karthikeya-ms/SAE-Aerodesign-Challenge-2020/SAE Aerodesign/final draft ppt.pptx

## SAEISS Aero Design Challenge 2020, Regular Class SASTRA Deemed To Be University, Thanjavur Technical Presentation

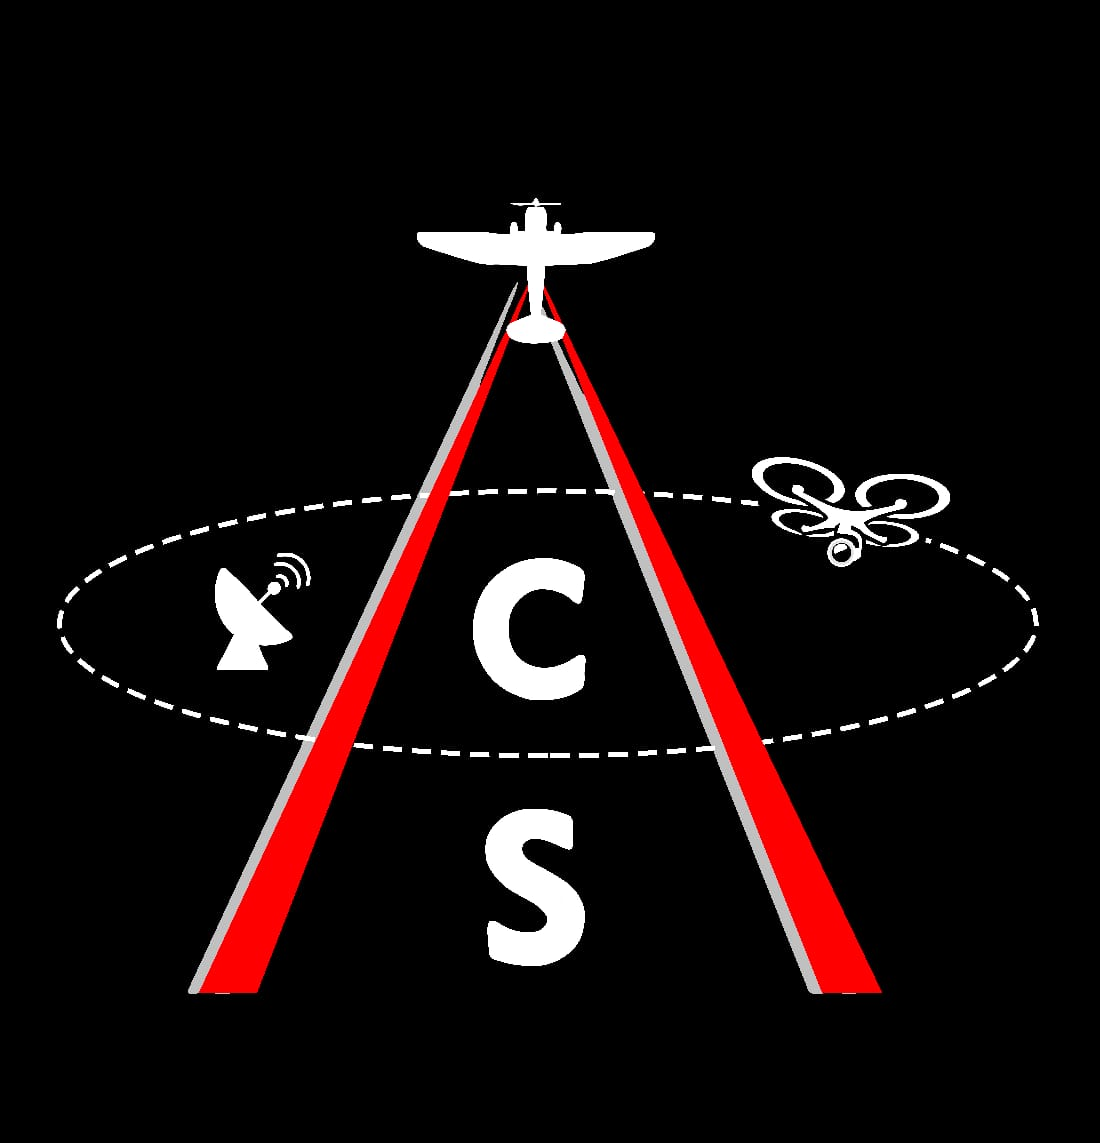
[picture p1: figure]

By
Team Udyat ADC2020114

## Project Planning

- Project approach
To practically apply our Theoretical Knowledge combined with our thought processes. Mimicking a fully functional aerospace engineering firm.
- Project Timeline

Team Registration and Memberships
Initial Discussions
Literature and Design Report Study
Sub-System Allocations and Working
Design Report completion and Submission
Fabrication /Technical Preparation
Test Flight and changes
Order of Components and Materials

Design Approach
- Conceptual Design
Detailed Design

## SAE AERO-DESIGN COMPETITION ROADMAP

- 2019

- 2020

- August

- Understanding problem-statement

- Team meetings
- Weight estimation

- September

- Modelling
- Design report

- December

- Semester exams
- Material selection
- Dealers contact

October

- Attending workshop
- Basic calculations

- November

- 2019-2020

- Final design report
- Scale down model

- Fabrication
- Technical presentation

TEAM UDYAT

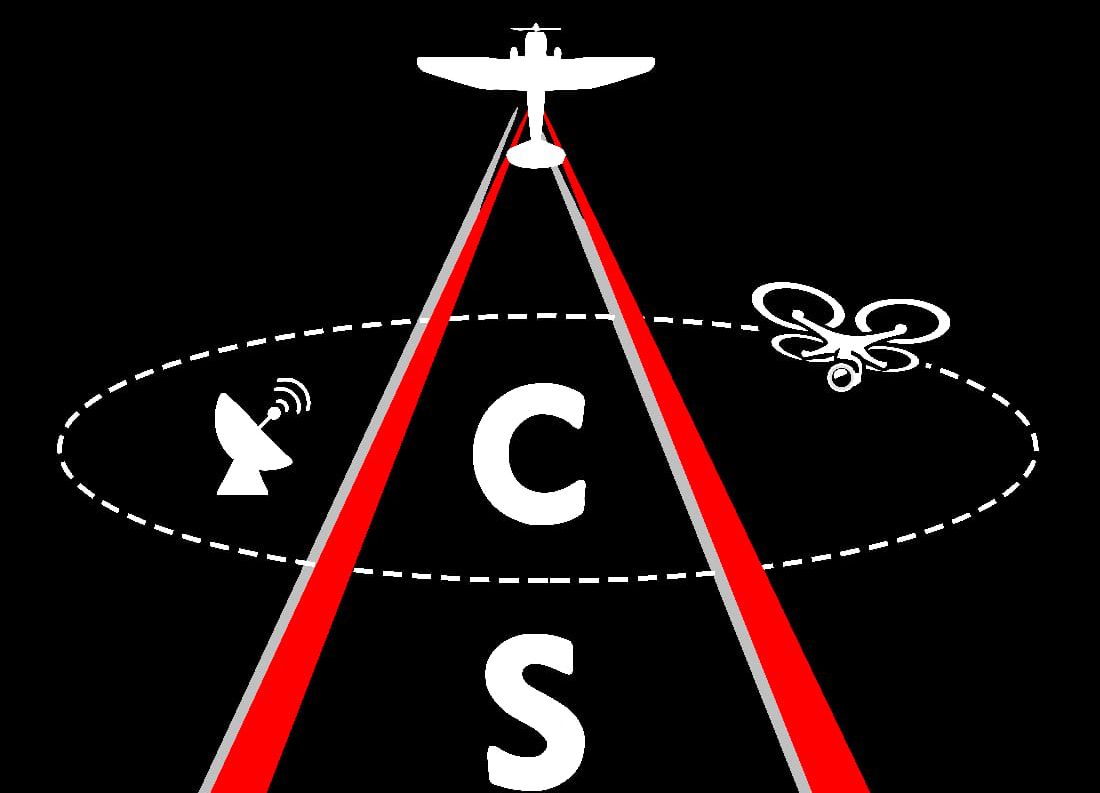
[picture p2: figure]

- January

- February

* Literature study is a part of all months

## Design Approach

Conceptual Design

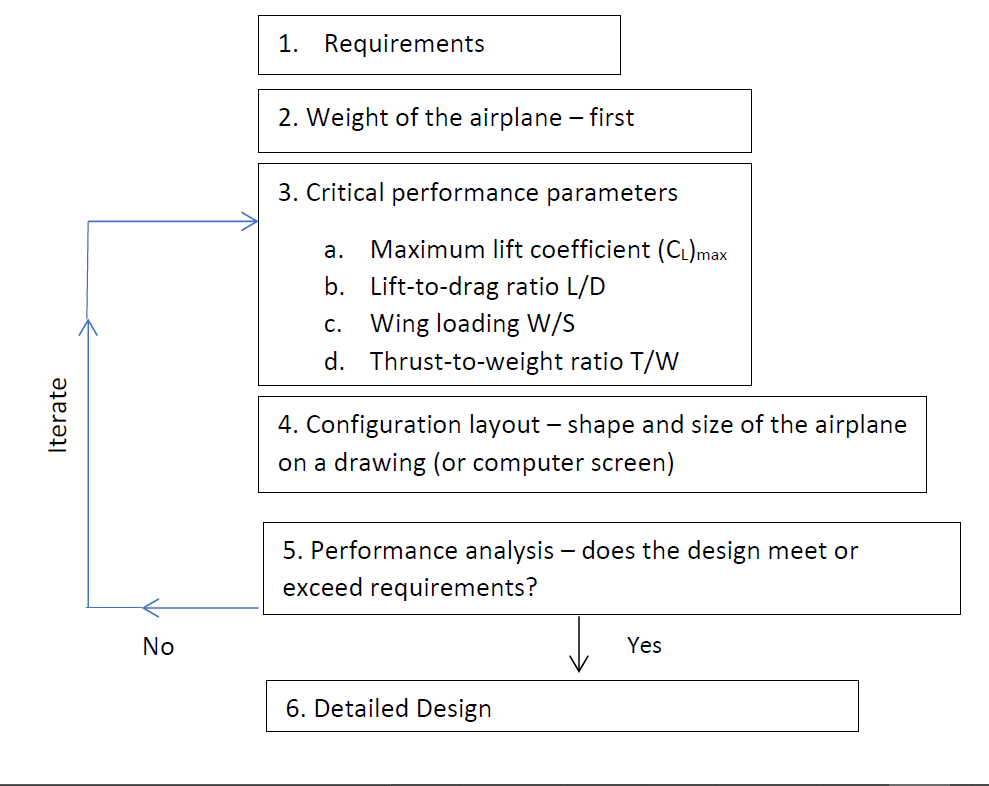
[picture p3: figure]

Detailed Design

1. 3-D drag analysis
2. Structural Analysis.
3. Power Plant.
4. Material Selection.
5. Fabrication Feasibility.

## Procedure

UDYAT plane
Weight estimation
Wing design
Empenage
Fuselage
C.G location
Landing gear

## Requirements and Constraints ( Include Sae plane)

Propulsion System

FRP and Lead Prohibited

Problem statement

Ss

SAE
Requirements and Constraints

Additional Constraints

Total Take off distance 200ft.
Total Landing distance 400ft.

Total Length <170 inches .
2kg <Weight<5kg

Time

Fabrication Feasibility

Cost

## Slide 7

FRP and Lead Prohibited

Propulsion System

Problem statement

SAE
Requirements and Constraints

Additional Constraints

Total Take off distance 200ft.
Total Landing distance 400ft.

Total Length <170 inches .
2kg <Weight<5kg

Time

Fabrication Feasibility

Cost

## Configuration Selection and Trade Studies

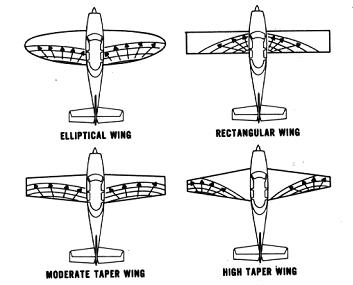
[picture p4: figure]
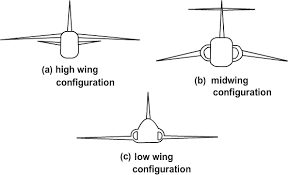
[picture p5: figure]

Evaluation Criteria:
- Less impact during landing
- Laterally stable
- Smooth finish of Fuselage
- Ease of Wing-Fuselage Assembly.

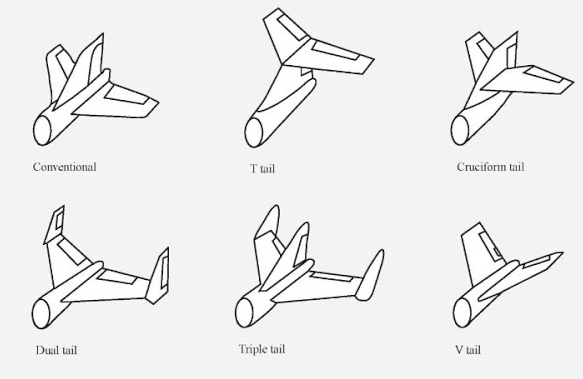
[picture p6: figure]
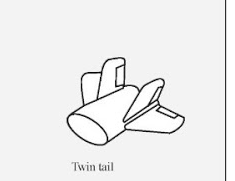
[picture p7: figure]

Evaluation Criteria:
- Induced drag
- Weight Reduction
- Near Elliptical Distribution
- Manufacturability

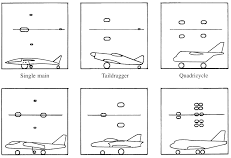
[picture p8: figure]

Evaluation Criteria:
- Reduced Parasite drag
- Reduced rudder-induced roll
- Free of fuselage wake
- Reduced Cantilever stress

Evaluation Criteria:
- Prevents Ground looping
- A
- Ad

Fuselage Evaluation Criteria:
- Innovation
- Reduced Influence of Wing wake on Tail
- Ease of manufacturing

## Vehicle Sizing

- Vehicle was sized based on competition requirements, meanwhile considering the aerodynamic characteristics and structural integrity.
- Aerodynamic parameters and Fabrication feasibility were considered, iterated and necessary design changes were made.

Airfoil Selection

Volume Coefficients

Horizontal Stabilizer Dimensions

Lift Requirement

Payload Requirement

Wing Dimensions

Avionics Requirement

Fuselage Dimensions

Vertical Stabilizer Dimension

## Slide 10

Wing

Wing configuration

Wing planforms

Airfoils

- Wortman fx-63-137
- E-423
- S1210
- S1223

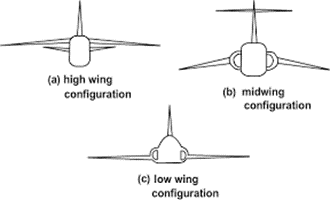
[picture p9: figure]
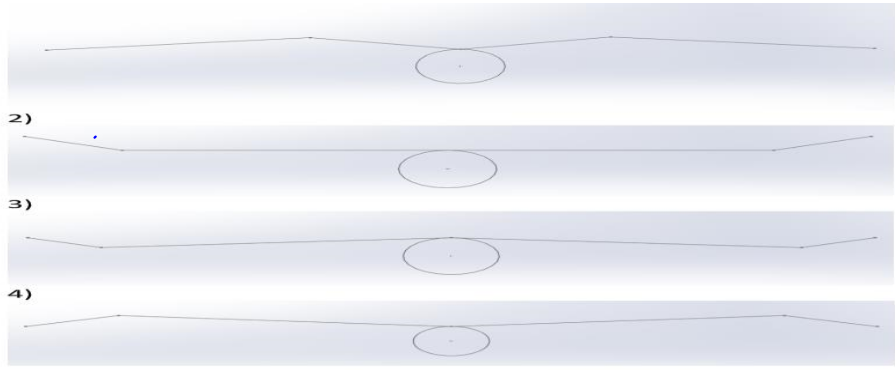
[picture p10: figure]

Wing specifications

## Slide 11

Fuselage

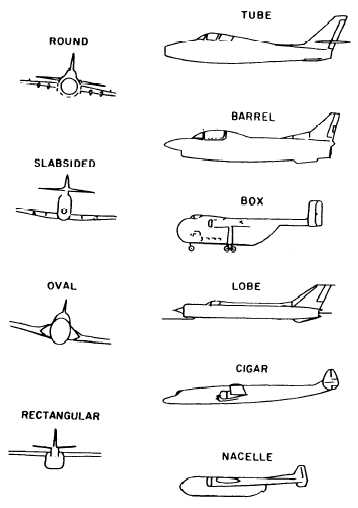
[picture p11: figure]

Fuselage front view

INNOVATION:
- The purpose of the step, it is claimed, is to allow some of the displaced air to fall into a pocket behind the step and become part of the airfoil shape as a trapped vortex. This purportedly prevents separation and maintains airflow over the surface of the airfoil. A similar step is made after the diverging part of fuselage to attach the flow and reduce the slope of decrease in lift.

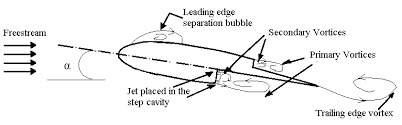
[picture p12: figure]
Image result for kline fogleman airfoil gif
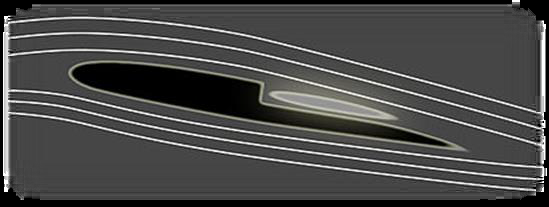
[picture p13: figure]
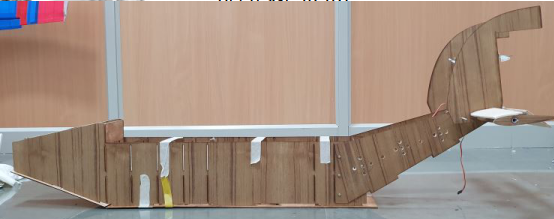
[picture p14: figure]

Fuselage side view

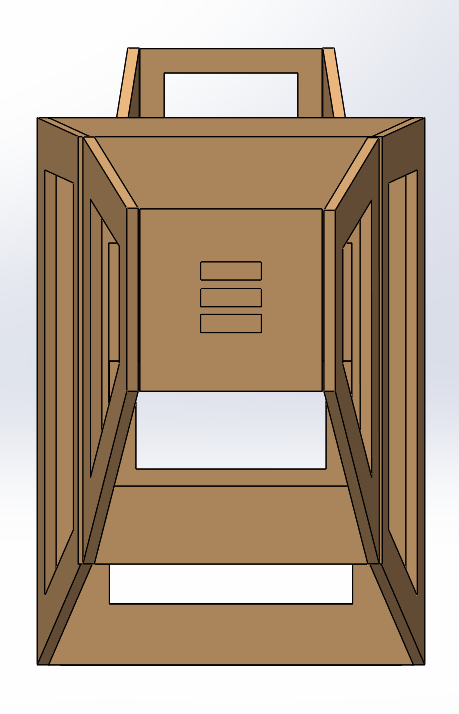
[picture p15: figure]
fuselage solidworks front view

## Innovation

- The purpose of the step, it is claimed, is to allow some of the displaced air to fall into a pocket behind the step and become part of the airfoil shape as a trapped vortex. This purportedly prevents separation and maintains airflow over the surface of the airfoil. A similar step is made after the diverging part of fuselage to attach the flow and reduce the slope of decrease in lift.

## Vehicle Sizing

Aerofoil Selection
(Wind-Turbine blades)

Performance Parameters

Maximum Lift Co-efficient

Maximum L/D Ratio

Wing-Loading

Informal Optimisation of Cruise-Velocity

Optimisation of Aspect Ratio

WING-DIMENSIONS

## Slide 14

- Vehicle was sized based on competition requirements, meanwhile considering the aerodynamic characteristics and structural integrity.
- Aerodynamic parameters and Fabrication feasibility were considered, iterated and necessary design changes were made.

Payload Requirements

Manufacturing Ease

Avionics Requirements

Fuselage Dimension

Volume Coefficients

Wing- Dimensions

Aerofoil

Vertical and Horizontal Stabiliser

## Slide 15

Vehicle Sizing

Performance parameters

Wing loading

Airfoil

Max L/D ratio

Aspect ratio

Max. lift coefficient

Wing Dimensions

Cruise velocity

Avionics requirement

Stabilisers

Volume coefficients

Payload requirements

Fuselage dimensions

Manufacturing Ease

## Slide 16

WING

Required Lift L=5.75Kg
Assumed Speed Vc=10m/s
Airfoil= S1223

Airfoiltools.com

For Wing: CLmaxw= Clmax * 0.95= 2.177
CL ideal = Cl ideal *0.95= 1.0973
For Aircraft: CLAmax = 2.177* 0.9=1.95
CLA ideal= 1.0973*0.9= 0.98

Lift = ½* ρ∗Vc2∗S∗CLmax.
56.4075= .5*1.225* 100* S* 1.95
Span area (S)= .4722 m2. = 732in2.

Landing Distance
Sg=1.21∗(W/S)/ (g∗ρ∗CLAmax∗T/w)

Span Length (b)= 71.58in
Mean Aerodynamic Chord MAC = 10.22in

Literature Study and Optimisation of Aspect Ratio.
A.R= 7

T/W= (1.21*20)/ (32.2*0.002377*1.95*200) = 0.81.

## Tail-Section

Horizontal Stabilizer
(PITCH STABILITY)
Literature Study NACA 0009, Volume Coefficient 0.6

Formal Optimisation of Span area
130 sq. in

- ARh=(2/3)ARw=4.66
- Span length=24.61 in
- chord=5.27 in
- Elevator chord=2 in
- Elevator length=24.61 in

Vertical Stabilizer
(DIRECTIONAL STABILITY)
Literature Study Volume Coefficient 0.05

Vv =. (Sv∗Lv)Sw∗b

Formal Optimisation of Span area
83 sq. in

- ARh=2.5
- Height=12 in

## Slide 18

Empennage

Horizontal & vertical Stabilizer

Tail cone side view

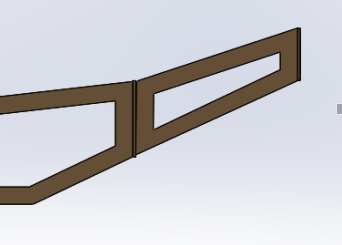
[picture p16: figure]
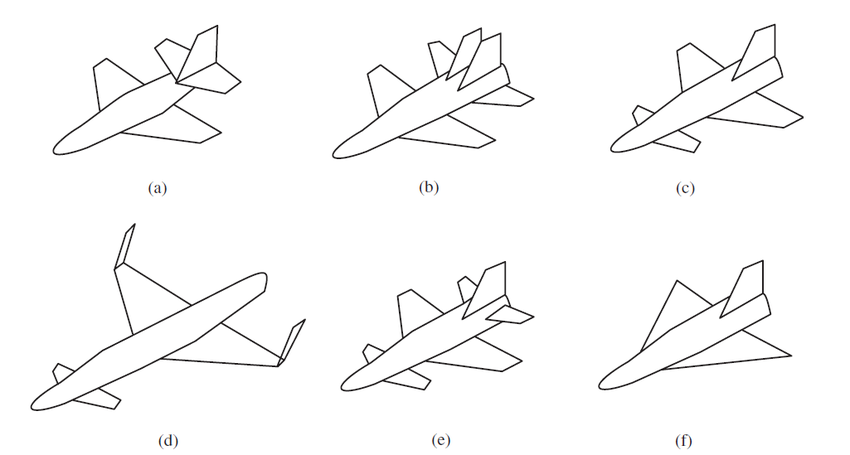
[picture p17: figure]
Image result for tail configuration

Airfoil-NACA0009

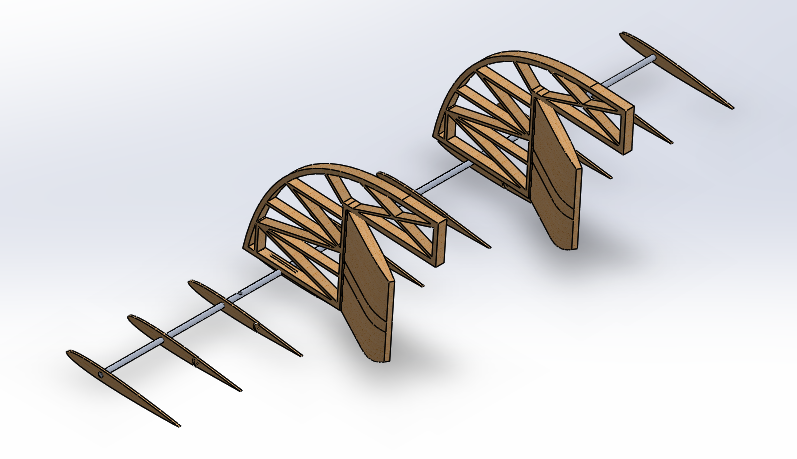
[picture p18: figure]
empennage isometric view solidworks

Tail isometric view

## Slide 19

Landing gear

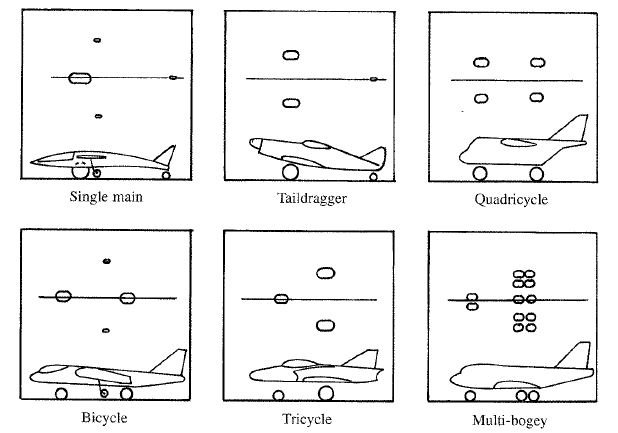
[picture p19: figure]

## Centre of Gravity and stability

Xflr
COG location using XFLR5: 1.997(from MAC of 10.1 in)

Analytical

Xnp = 3.027 inches (for 10.1 inches MAC).
We chose the mid value of Stability margin which is 0.10.
Xcg = 2.017 inches (from MAC of 10.1 inches).

## Stress analysis and Material Selection

Distance Between Ribs:

Cp=(Po−Pa)/ 5∗ρ∗Vc².

| Density, g/cc | Strength, MPa | Specific strength | Youngs Modulus, GPa | Flexural Modulus, GPa | Elongation, % | Fatigue Mpa
Balsa Wood | 1.63 | 30 | 18.40 | 3.71 | NA | NA
Depron | NA | NA | NA | NA | NA | NA
Corrugated plastic | NA | NA | NA | NA | NA | NA
Elasto foam | NA | NA | NA | NA | NA | NA
FRP | 1.5 | 85 | 56.67 | 3.4 | 3.6 | 5
PLA | 1.25 | 65 | 52.00 | 3.5 | 4.5 | 12
ABS | 1.08 | 55 | 50.93 | 3.1 | 2.5 | 20
Nylon 6 | 1.12 | 70 | 62.50 | 3.1 | 2.6 | 35
Nylon 66 | 1.14 | 90 | 78.95 | 2.9 | 2.4 | 45
PEEK | 1.3 | 95 | 73.08 | 4 | 3.8 | 45
Torlon | 1.42 | 170 | 119.72 | 4.9 | 5 | 15
Al 7075 T6 | 2.7 | 570 | | 71GPa | | 10 | 300

Material Selection Trade-Off

Po−Pa= 350 Pa

Iterative Process

## Empirical Results

## Lessons Learnt

- We have the aerodynamic knowledge, the structural materials, the powerplants, and the manufacturing capacities to perform any conceivable miracle in aviation. But miracles must be planned, nurtured, and executed with intelligence and hard work”.
- Glenn L. Martin, aviation pioneer and manufacturer, 1954.
- Checking the availability of necessary components before coming to design conclusions.
- Fabrication and Manufacturing required a yet another different set of skill.
- Time Management
- Finance management

## Queries?
