karthikeya-ms/SAE-Aerodesign-Challenge-2020/SAE Aerodesign/SAE_Aerodesign 2020 Final report.pdf

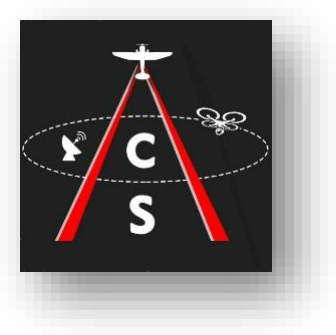
[picture p20: figure]

Society of Automotive Engineers

Aero Design Challenge 2020

(SAEISS-ADC 2020)

## Design Report of an Electric Motor-Powered Radio Controlled Heavier-

than-air Regular class Aircraft.

Submitted by

Team Udyat (ADC2020114)

SASTRA Deemed to be University, Thanjavur

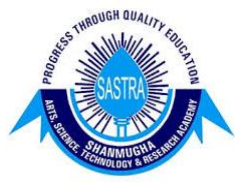
[picture p21: figure]

M Siva Karthikeya | B Harshin Balaji
Pothabathula Hema Prathyusha | S N Vijay
Prateek Boga | Amal Xavier Christo.C

### M S Hari Krishna (Team Captain)

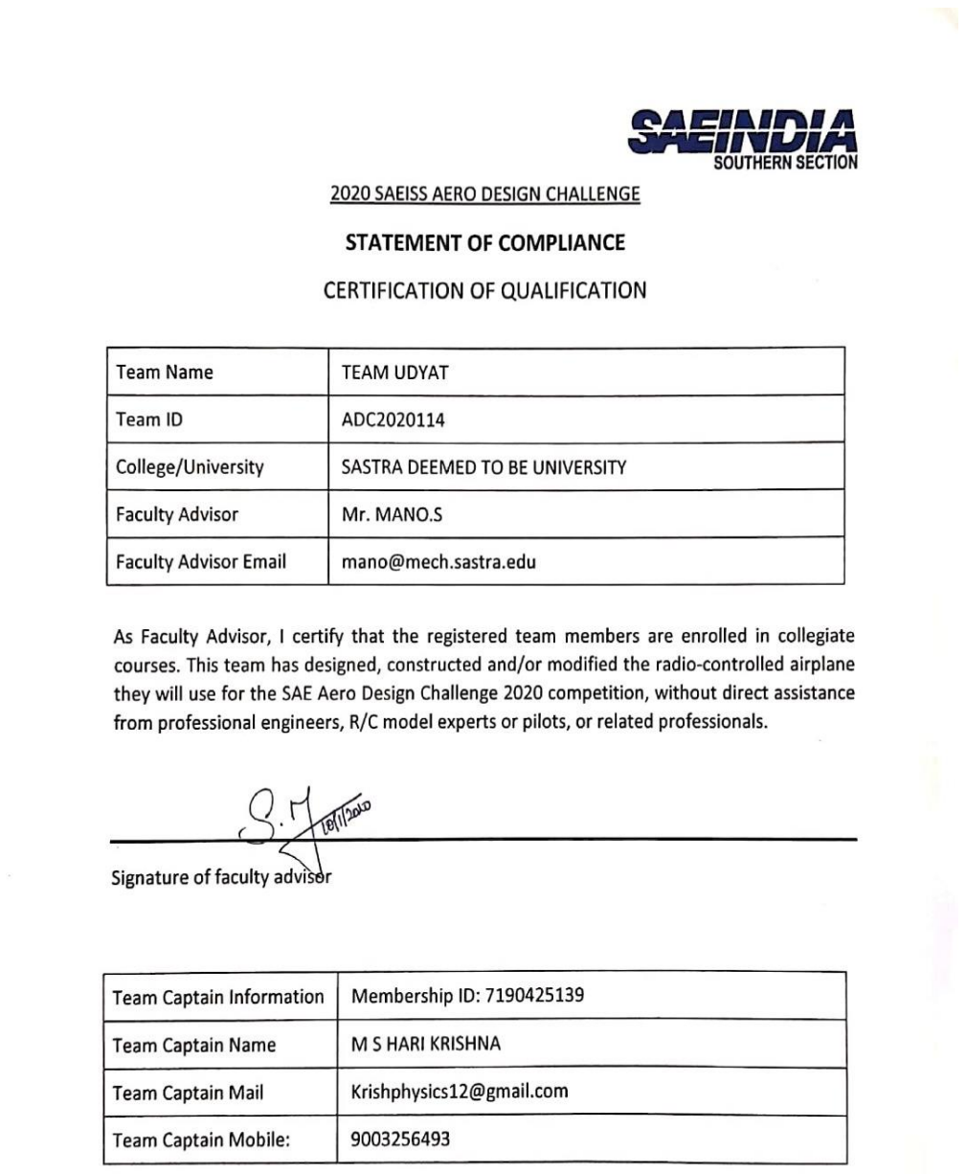
[picture p22: page 2]

TABLE OF CONTENTS:

3.1.4.4 Fuselage construction

8. 2D diagram and References | 30, 31

### 1. Acknowledgement

‘No man is an island’ said John Donne. Team Udyat is lucky to be connected to many others who keep

us from being ‘rifted’. For creativity has no greater sustenance than the love and support of others, we

would like to spare this page to acknowledge some of them.

We thank our parents and family members, without whom finishing this report successfully on time

would have been strenuous.

Dr. P. Bala Srinivasan- Associate Dean (Research), School of Mechanical Engineering, SASTRA

University. He has been our teacher, mentor, well-wisher and has constantly encouraged us in all our

challenging situations. We thank him for his guidance in ‘Material selection’.

Dr. Hariharan Sankara Subramanian, SAP, SASTRA University, for guiding us through all SAE-

related procedures.

Mr. Mano. S, Faculty advisor of Team Udyat, for his guidance and support since the beginning of this

project.

Our Seniors: M. Narasimha Vardhan (IIT-M), Lakshmi Das and S. Shyam, for sharing their

experiences and knowledge in aeromodelling. Their suggestions and pointers have been of immense

help in executing this project. We are extremely grateful for their support.

Our friends: S. Nithish Kumar for being a part in all our discussions and correcting us whenever

required; A. Ithikhash for giving us the ‘feel’ of materials and in finding dealers; Shreya

Venkataraman for patiently editing this document.

We finally thank almighty for his blessings!

### 1. Introduction:

Engineering: “The application of scientific principles to practical ends”- American Heritage Dictionary

This was the motto behind the formation of Team Udyat, a team of seven engineering students from

Aerospace and Mechanical Department of the Aeromodelling club at SASTRA(ACS). We decided to

utilise the golden opportunity of taking part in the annual Aero Design Challenge 2020 organised by the

Society of Automotive Engineers (SAEISS), which we consider as a great platform to practically apply

our theoretical knowledge combined with our thought processes.

There are two classes- Regular and Micro. Following an intense discussion and thorough understanding

of the rules, Team Udyat decided to take part in the Regular class. As we had experience only in making

micro class vehicles, the main objective behind choosing the Regular class was to challenge our fear of

making a huge aircraft with good flight performance that adhere to the rule book prescribed by SAEISS.

Here, I would like to proudly add that our college seniors, Team BALLISTIC took part in SAEISS ADC

2017 and won overall 2nd. Their guidance and moral support gave us immense confidence to initiate this

project.

Project Planning:

“We have the aerodynamic knowledge, the structural materials, the powerplants, and the manufacturing

capacities to perform any conceivable miracle in aviation. But miracles must be planned, nurtured, and

executed with intelligence and hard work”.

- Glenn L. Martin, aviation pioneer and manufacturer, 1954.

Our initial team meetings mainly consisted of discussions on how to approach this project, as SAEISS

not only looks for an airplane design that is certified best for flying, but also assesses the student’s team

dynamics, discipline in approaching a problem, and various other skill sets.

### 2. Design approach:

We decided to split our process of fabricating this aircraft into two phases, namely, Conceptual Design,

and Detailed Design. These two covers the web of details that surrounds and interconnects all other

parameters that is required for designing an efficient airplane.

2.1Conceptual Design

We covered 5 pivot parameters under this heading, which is given below as a flow chart.

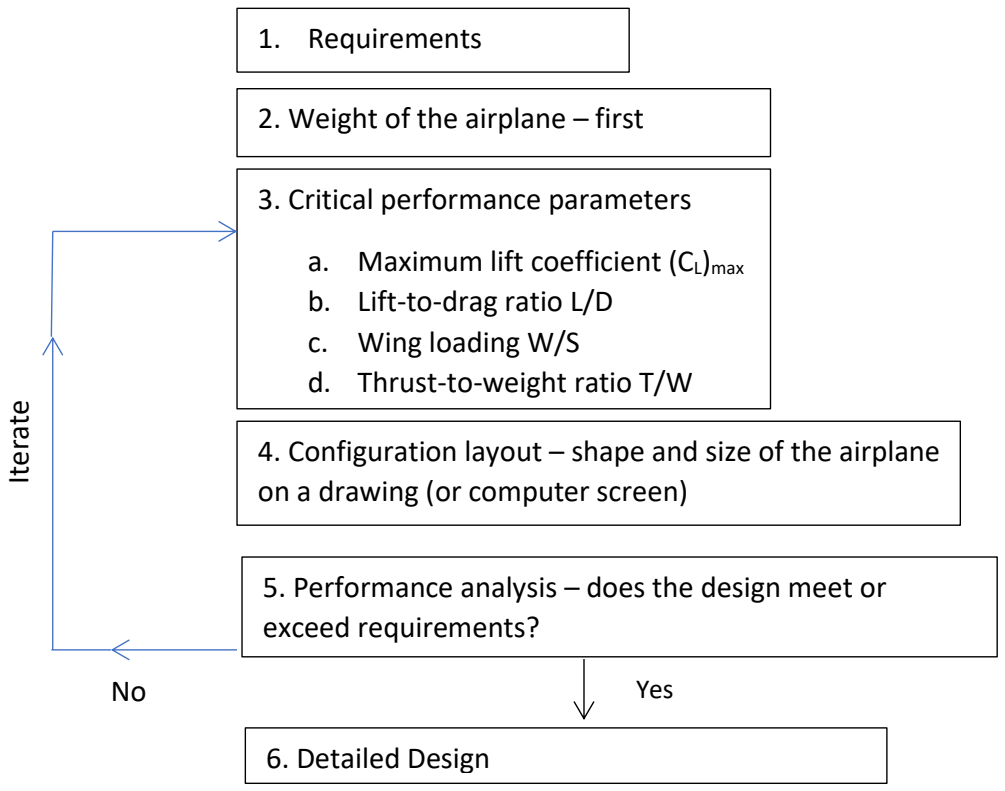
[picture p23: figure]
exceed requirements?; 6. Detailed Design; 1. Requirements; 2. Weight of the airplane – first; 3. Critical performance parameters; a. Maximum lift coefficient (CL)max b. Lift-to-drag ratio L/D c. Wing loading W/S d. Thrust-to-weight ratio T/W; on a drawing (or computer screen); Iterate; Yes

### 3.1.1. Requirements and constraints:

- To design an aircraft that can lift as much as weight as possible while observing the available

power and aircraft dimensional requirements. Accurately predicting the lifting capacity of the

aircraft is an important part of the exercise as prediction bonus points often determine the

difference in placement between competing teams.

5. Performance analysis – does the design meet or
4. Configuration layout – shape and size of the airplane

- Total dimensions of airplane not more than 170 inches.
- Total weight of empty aircraft not less than 2 Kgf and not more than 5 Kgf.
- Use of FRP is prohibited.
- LiPo battery 4 cell – 6 cells.
- Total Take-off distance- 200ft
- Total Landing distance- 400ft.

### 3.1.2. Weight of the Airplane - First Estimate & Material Selection:

No airplane can get off the ground unless it can produce a lift greater than its weight. Hence, it was

important to consider and approximately calculate the gross weight of the aircraft as all the other

aerodynamic parameters such as lift, thrust required, span length of the wing, etc. depended on it.

We classified the gross weight in to two - Weight of the payload (Wp) and empty weight of the aircraft

(including electric components, We).

The primary purpose of this aircraft is to have a stable flight and lift as much payload as possible, for

which having a higher payload fraction is essential. Payload fraction is defined as the ‘ratio of weight of

the payload to the take-off weight of aircraft’. This can be achieved by decreasing the empty weight of

the aircraft. Since the minimum weight of the aircraft should be 2Kgf, we considered building an aircraft

weighing 2.3Kgf, leaving a clearance of 300g. We were very particular with this consideration as there

were high chances of increase in weight upon building. We made sure that the weight didn’t exceed

5Kgf. This was also a deciding factor in the selection of material (density). The empty weight of the

aircraft depends on the materials used and the electrical components. Intense study and research were

done for the selection of material. This was done to quench our thirst in discovering several non-

conventional, sustainable materials that can be used to build RC planes. After analysing the pros and

cons, cost, availability, ease of manufacturing and the other material parameters mentioned, we decided to go with Aluminium and various grades of Balsa wood. Although these are conventional materials,

this activity helped us explore a variety of materials, their manufacturing processes, cost and

availability. After going through literatures, we contemplated our payload fraction to be 0.6, which

yielded a result that our aircraft can lift a payload of 3.45Kgf.

Conclusion: The gross weight of the aircraft (We + Wp) = 2.3Kgf + 3.45Kgf = 5.75Kgf = 12.676lb.

### 3.1.3. Performance parameters:

An estimation of critical performance parameters like CL max, L/D, T/W, W/S was made as they form

the ultimate deciding criteria for calculation of span length, chord, aspect ratio, thrust required, etc.

Maximum Lift Coefficient: This is the stage where we made an initial choice of the airfoil. The aircraft

should be able to perform a stable 360⁰ turn. Hence, high speed and manoeuvrability can be neglected.

From historical data, Reynolds number for an RC aircraft ranges from 1,50,000 to 2,50,000, and upon

choosing an average value of 2,00,000, the average Cruise velocity obtained (Vc) is 9-10m/s (Ref.

airfoiltools.com).

Take off speed (VTO)= Cruise speed/1.2 = 7.8m/s. Stall Velocity = VTO /1.2 = 5-6m/s.

Now, the problem statement is to produce high lift at a relatively low Reynolds number, i.e. 2,00,000.

This is when wind turbines drew our attention, whose blade profile is capable enough to produce high-

lift in a velocity range of 9-10m/s. Research work made us shortlist the below mentioned airfoils:

- Wortman fx-63-137
- E-423
- S1210
- S1223

Design Objective | Weightage | Wortman | E-423 | S-1210 | S-1223
Cdmin | 25% | 5 | 3 | 5 | 4
Cmo | 15% | 2 | 3 | 3 | 4
Clmax | 15% | 3 | 4 | 4 | 5
αo | 10% | 3 | 3 | 4 | 4
(Cl/Cd) max | 10% | 5 | 2 | 4 | 3
Clα | 5% | 2 | 3 | 3 | 4
Stall Quality | 20% | 2 | 2 | 3 | 5
Summation | 100% | 3.30 | 2.85 | 3.85 | 4.25
Table.1

Comparatively, the overall performance of S-1223 proved to be better. This was a validation to our gut-

feeling that S-1223 would inherently perform well since it is widely used for RC plane (Historical data).

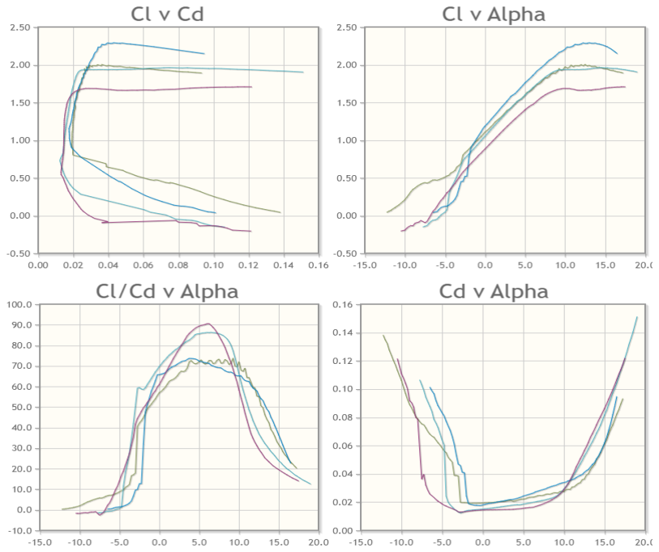
[picture p24: figure]

Colour code:

Pale blue: S1210

Blue: S1223

Green: E423

Violet: fx-63-137

Specifications of S-1223:

Clmax @ A.O.A=16⁰ | 2.2919
Cl @ A.O.A= -7.5⁰ | 0
(Cl/Cd) max @ A.O.A =3.75⁰ | 73.64
Cl ideal (Cl ideal is when the corresponding Cd is minimum) | 1.1554
Cd min | 0.01758
Cl @ A.O.A=0⁰ | 0.01758
(Thickness/chord) max = 12.1/19.8 | 0.611
Parasite Drag Co-efficient (Cd0) | 0.01758
dCl/dα | 5.698
Table.2 | source:www.airfoiltools.com

Note: The aircraft has to fly at ideal lift co-efficient of 0.98 for it to experience minimum drag.

The gross weight of the aircraft is 5.75 Kgf. At cruise condition, Lift = Weight. Hence, the aircraft

should produce a Lift of 5.75*9.81= 56.4075N.

Lift = ½* ρ ∗ Vc²
∗ S ∗ CLmax.

56.4075= .5*1.225* 100* S* 1.95

Span area (S)= .4722 m². = 732 in².

Wing Loading (W/S): Wing loading is defined as the ratio of gross weight of the aircraft to the span area.

The faster an aircraft flies, more is the lift produced at each unit area of wing, since free stream velocity

is directly proportional to lift. Hence, even with a small span area, more weight can be lifted just by

increasing thrust and thus velocity.

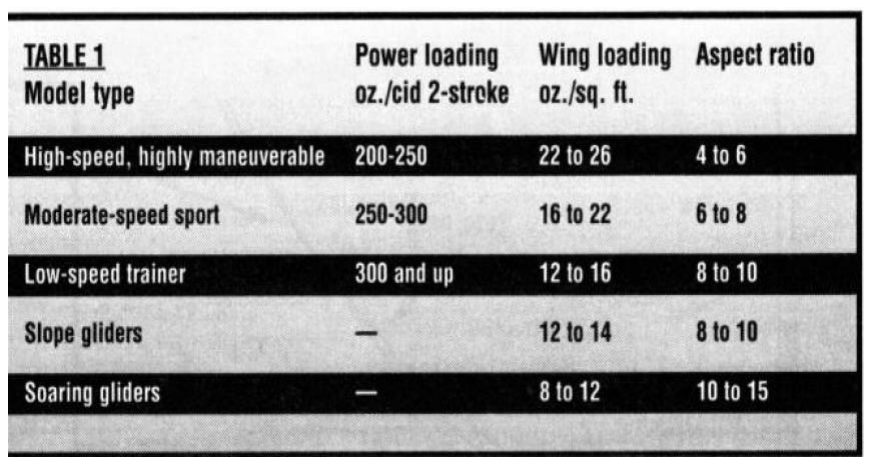
[picture p25: figure]

From the table, wing loading range of 16-22

oz/ft² is chosen. We arrived at this conclusion

because the requirements of a regular class

aircraft given by SAE restricts battery usage from

4-cell to 6-cell, which when powers a BLDC

For Wing: CLmaxw= Clmax * 0.95= 2.177

CL ideal = Cl ideal *0.95= 1.0973

For Aircraft: CLAmax = 2.177* 0.9=1.95

CLA ideal= 1.0973*0.9= 0.98 motor, generates speed that falls under moderate speed sport category. The corresponding Aspect ratio is

6-8, an average value of 7 is chosen. Aspect ratio = Span length (b) / Span area (S).

Thus, Span Length (b)= sqrt (732*7) = 71.58 in.

Mean Aerodynamic Chord (MAC)= Span (b) /Aspect ratio= 10.22 in.

Lift to Drag Ratio (L/D):

From Fig, the Cl/Cd max ratio for S-1223 is found to

be 73.64 at an angle of attack of 3.75. The

corresponding Cl and Cd is found to be 1.6172 and

0.02196 respectively. This is only for the airfoil, the

L/Dmax for the entire aircraft is calculated in 3-D drag

analysis section using drag polar equation.

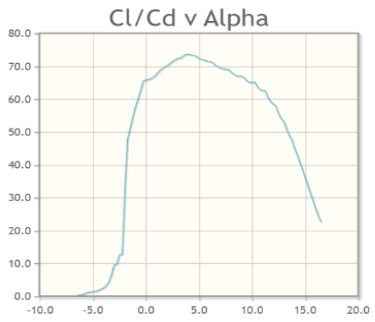
[picture p26: figure]

Thrust to Weight Ratio (T/W):

The value of T/W determines in part the take-off distance, rate of climb, and maximum velocity. Take-

off distance constraint is examined in here.

Sg = 1.21 ∗ (

W
S

)/ (g ∗ ρ ∗ CLmax ∗

T
w

)

Where, Sg is ground roll distance = 200ft.

W/S is wing- loading, taken as 20oz/ft² from wing-loading table given above.

g= acceleration due to gravity= 32.2 ft/s².

CLmax = 1.95

ρ= Density at sea-level= 0.002377 lb/ft

3

T/W= (1.21*20)/ (32.2*0.002377*1.95*200) = 0.81.

### 3.1.4. Configuration Layout:

Based on the information that has been calculated so far, the picture of aircraft with dimensions is

drawn. This section of intellectual process of airplane design is where intuition, experience and the art

of airplane design most strongly come in to play. We began with wing design (primary lift producer).

Number of wings-

(a) Monoplane | (b)Biplane
(c) Tri-Wing

Monoplane was chosen due to the below-mentioned advantages over any other number of wings.

1) Less weight, Ease of manufacturing and assembly operation.
2) Highest efficiency and lowest drag when compared to other configurations.

Wing vertical location- Feasibility analysis was performed to decide upon the vertical location of the

wing. Design objectives were narrowed down and each of it was given a specific weightage and then

rated accordingly for every vertical location. High wing has got the highest rating out of all due to many

reasons such as-

1) Facilitates the loading and unloading of payload into and out of the aircraft.
2) During landing, load on the landing gear will be transferred to the fuselage and very less to the wing

thus protecting the wing from harsh landings.

3) It increases the dihedral effect and makes the aircraft laterally more stable.
4) Aerodynamic shape of the fuselage lower section can me made smoother.

3.1.4.1 Wing design- From the primary dimensions of the wing obtained in the previous section such

as the chord length,

span length and span

area, the team had

intense brainstorming

sessions to decide on

the | wing

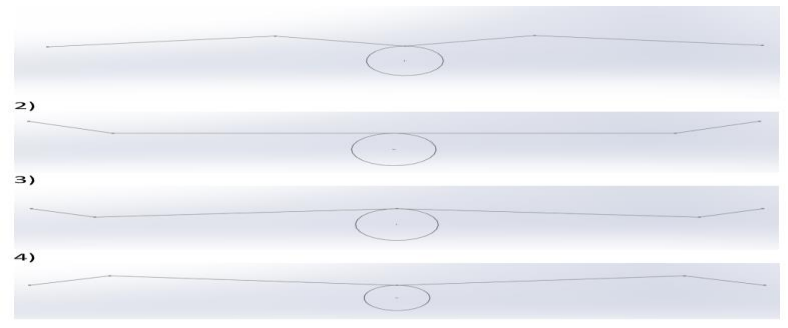
[picture p27: figure]

configuration. We came up with 4 different wing designs drawing inspiration from nature which are

shown above.

During the decision-making process 8 important parameters had to be considered before arriving at a

particular wing configuration. They are:

1) Aspect ratio-

It's the ratio of a wing's length to its chord. Both low aspect ratio and high aspect ratio wing have both

advantages and disadvantages so a middle value was taken. The aspect ratio was chosen as 7.

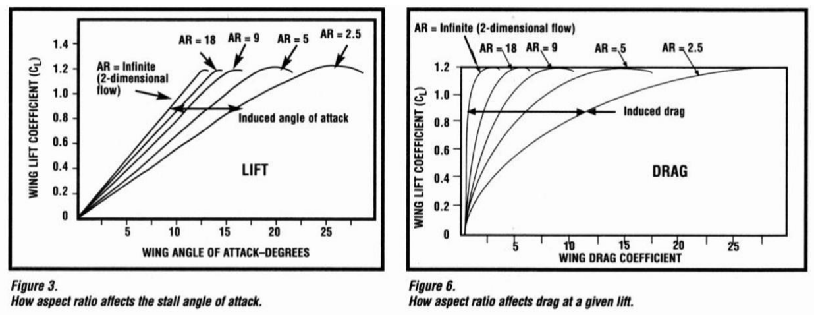
[picture p28: figure]

2) Taper ratio-

The prime purpose of tapering our airplane wing is to attain elliptical lift distribution which has the

highest efficiency when compared to any other distribution. One way to attain this is by making the

wing planform elliptical which is done by varying the chord length gradually across the span length.

This type of wing though aerodynamically has the best characteristics, is rated the least when the

manufacturing aspect is considered.

When the team was doing

literature study to find other ways

of | attaining | elliptical | lift

distribution, we came across the

concept | of | taper. | The | lift

distribution of a tapered wing is

very close to elliptical and the

factor that tells us about this

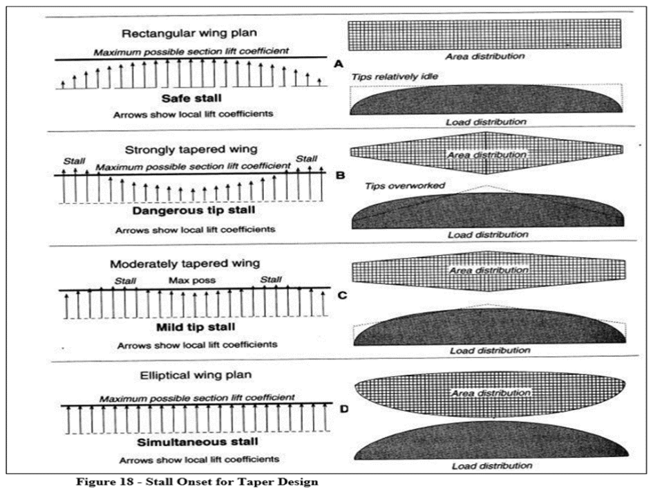
[picture p29: figure]

closeness is the Oswald span efficiency factor (e). For a tapered wing, this factor lies in the range of 0.90

to 0.98. Also, another factor to consider after deciding to taper the wing is the taper ratio which is

defined as the ratio of tip chord to root chord. Taper ratio= Ct / Cr

Optimum range of taper ratio for an RC plane is 0.2 to 0.6. Beyond 0.6 or below 0.2 the wing

experiences a phenomenon known as tip stall which is considered extremely dangerous for a plane

during flight. We decided the Taper ratio of our plane to be 0.58.

3) Sweep angle- Since Sweep angle is used in aircraft which fly in supersonic and high-speed subsonic

regions and our plane is designed to fly in low subsonic region, the sweep angle is neglected.

4) Tip chord and Root chord- After deciding the span area and the aspect ratio for a moderate category

aircraft, wing’s mean aerodynamic chord can be decided using the below mentioned formulas.

b

2 / S = AR | b / c = AR

The MAC obtained by the team was 10.1 inches. Root chord and tip chord can be calculated using the

below mentioned equation

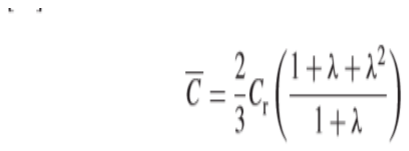
[picture p30: figure]

Root chord- 12 inches, Tip chord- 7 inches, MAC- 10.1 inches

5) Dihedral angle-

It is the upward angle from the horizontal of the wings. The purpose of dihedral angle is to provide

lateral stability. Dihedral angle 5 degrees was chosen (historical data).

6) Aerodynamic and Mechanical twist- Aerodynamic

twist: If the tip airfoil and the root airfoil are not the

same, the twist is referred to as aerodynamic twist.

Geometric twist: When the tip incidence angle and the

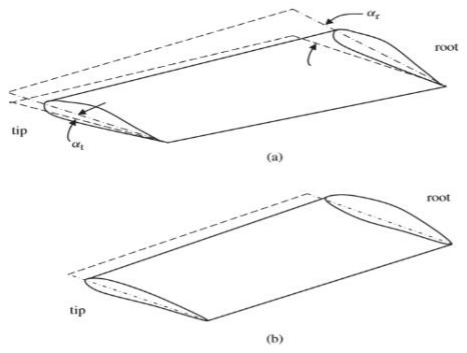
[picture p31: figure]

root incidence angle are not same, the twist is referred to as geometric twist.

Two major goals for employing a twist (aerodynamic or mechanical) in a wing are-

1) To avoid tip stall
2) To modify the lift distribution into an elliptical one

Even though providing twist can drastically vary the properties of a wing favourable to us, it brings

immense difficulties from a manufacturing point of view. Since ease of manufacturing was top priority

among all other aspects, we decided not to include a twist in our wing.

7) High lift devices – High Lift Device is a component that increases the amount of lift produced by the

wing. The device may be a fixed component, or a movable mechanism which is deployed when

required. We have gone with flaps which is the most commonly used high lift device.

Types of Flaps- From the list of flaps mentioned,

the team decided to go with Plain Flap due to the

following reasons- 1) Simplest and earliest type of

High lift device. 2) Camber can be increased

mechanically which results in an increase in lift. 3)

Easiest to build.

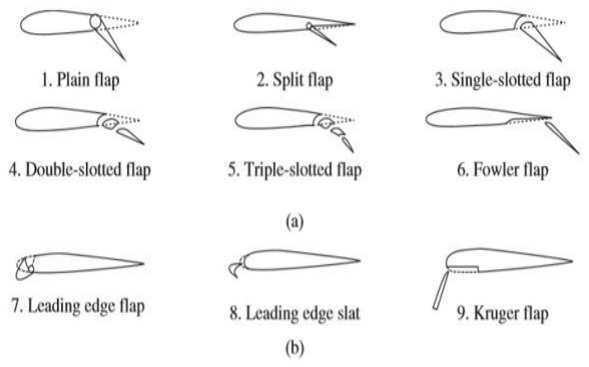
[picture p32: figure]

8) Wing setting angle –

α= α0 + ((18.24*CL*(1+T))/AR.

α0 is the range of 6-7

0.
α = 10-11

0

but α(L=0) = -7.5⁰.

therefore, αsett = 2.5 – 3.5 {No problem of stall}. | The αsett = 2.5 to 3.5.
3.1.4.2. Horizontal Stabilizer: The main purpose of horizontal stabilizer is pitch stability.

The airfoil selected is NACA 0009 (Literature study). The tail plane needs to produce both positive lift

and negative lift. For this reason, a symmetric airfoil section is a suitable candidate for a horizontal tail.

The horizontal tail volume coefficient usually lies in the range of 0.3 to 0.6 for a well-behaved aircraft.

If Vh is too small then the aircraft’s pitch behaviour becomes sensitive to the CG location and will show

poor tendency to gusts. So, it was taken as 0.6.

Where,

Sh = span area of horizontal stabilizer | S= Span area of the wing
Lh= horizontal tail moment arm | C= Wing mean chord
The Lh is found by using the below formula | Lh= Kc*(4*c*S*Vh/π*Df) ^0.5

Kc= correction factor varies between 1 and 1.4

Df= Effective diameter of the fuselage

as Lh=34inches.

Substituting the values for the above parameters, we obtained Sh as 130 inch².

Aspect Ratio of horizontal stabilizer was found to be 4.66. We have considered a rectangular horizontal

stabilizer. The span length is 24.61 inch the chord is 5.27 inch. Around 40% of the horizontal stabilizer

area was allotted for the elevator, resulting chord of the elevator to be 2 inches and the length to be

24.61 inches.

The Cl of the horizontal stabilizer was found to be -0.368. Which is sufficient to counter the moment

generated by the wing.

3.1.4.3. Vertical Stabilizer: The main functions of Vertical stabilizer – (1) Directional Stability (2)

Directional Trim. Low Aspect ratio to attain high stalling angles. Thus, it was chosen as 2.5.

Vertical tail volume coefficient, Vv =.

### (Sv∗Lv) Sw∗b

Where,

Sv: Vertical tail area | Lv: Vertical tail moment arm
Sw: Wing area | b: Wing span

The vertical tail volume coefficient lies in the range of 0.02 - 0.07 (Historical data). Higher the value

more the stability. Hence, 0.05 is considered. For an aircraft with a tractor- propeller, the tail arm is

about 60% of the fuselage length and was found to be 31.2 inches. The rudder area is generally 40% of

vertical stabilizer area. The vertical tail area is found to be 83 in². Aspect Ratio = 1.55 * h²
/Vv

Height of the vertical stabilizer is calculated to be 12 inches (formula above). Twin tail configuration is chosen (reduces cantilever stress at the root and less parasite drag); each vertical stabilizer’s height is 6

inches with an area of 41.5 in².

### 3.1.4.4. Fuselage Construction:

The fuselage of the aircraft is the component to which essentially everything is attached and it must be

large enough to accommodate the motor casing, battery and other electrical components in the nose,

payloads, ballast compartment (if necessary), provisions for control rods and electrical wires to run

through wings and fuselage undisturbed. The overall length of the fuselage is 50 inches, approximately

65% of Span (Historical data) with tapering width and varying height. The rear, empennage section of

the fuselage is placed at an inclination of 22.4⁰ with the longitudinal axis to prevent the horizontal

stabilizer and elevator being influenced by the wake produced by the main wing. The payload bay’s

location is designed to coincide with that of Centre of Gravity (C.G)- position of C.G remains the same

before and after loading the payload. Material used for the construction is Balsa wood and Aluminium

rods (stringers and reinforcements).

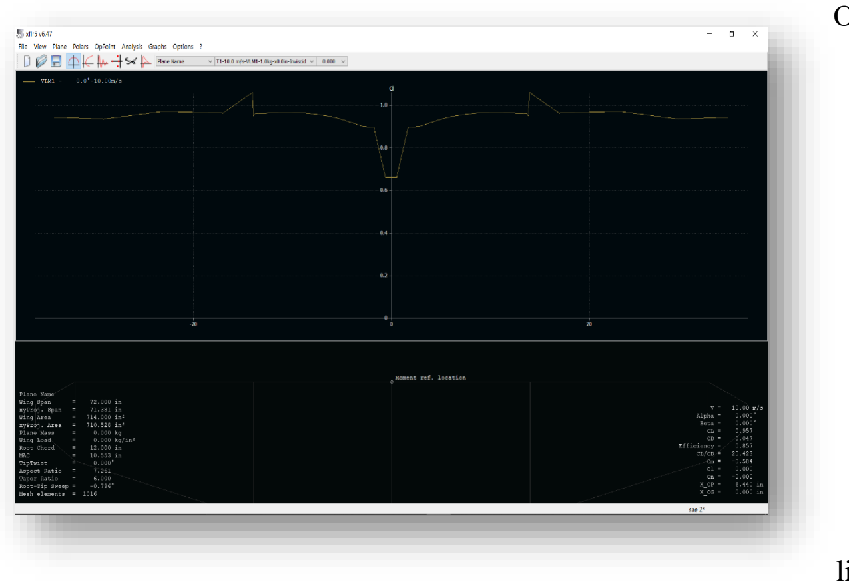
[picture p33: figure]

Our drag analysis for the ‘attached

wing and fuselage’ design

yielded results where there was

increase in drag and steep

decrease in lift, as expected

(picture). A brain-storming

session gave us an idea to

reduce the slope of reduction in

lift. Drag can be reduced if the

flow separation is delayed. We tried to draw the principle used in Kline-Fogleman airfoils and applied it

to our fuselage.

3.1.4.5. Innovation: The Kline–Fogleman airfoil or KF airfoil is a simple airfoil design with single

or multiple steps along the length of the wing, designed by Richard Kline and Floyd Fogleman. The

| purpose of the step, it is claimed, is to allow some of the
| displaced air to fall into a pocket behind the step and
| become part of the airfoil shape as a trapped vortex. This

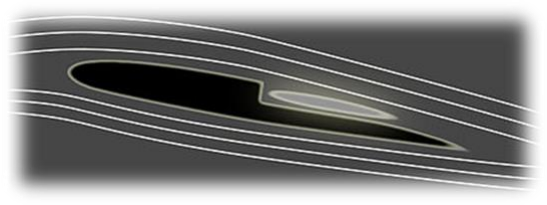
[picture p34: figure]

purportedly prevents separation and maintains airflow over the surface of the airfoil. A similar step is

made after the diverging part of fuselage to attach the flow and reduce the slope of decrease in lift.

### 3.1.5. Centre of Gravity and Stability Analysis:

One of the most important characteristics to consider while designing an aircraft is its inherent stability

and controllability. Even though evaluating the stability of an aircraft is a complicated process when

evaluated computationally, we have alternative analytical methods which give reasonable estimates and

are vastly simpler to apply.

COG of the aircraft was estimated analytically as well

as using XFLR5 by placing all the electrical

components and payload as point masses.

COG location using XFLR5: 1.997(from MAC of 10.1 in)

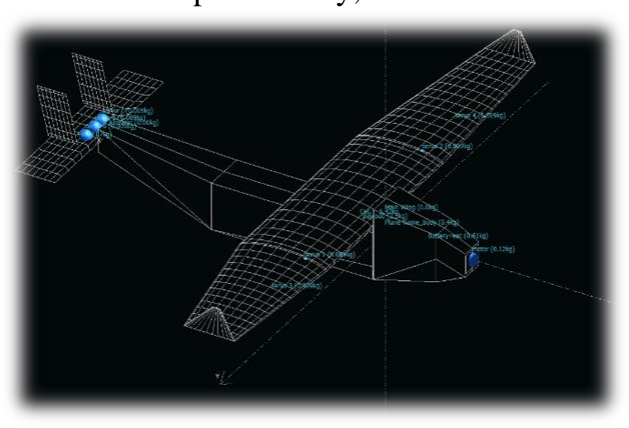
[picture p35: figure]

Analytical method: Effects of moving COG:

Move COG forward: Increased stability => The aircraft is more resistant to AOA and Velocity changes

Move COG backward: Decreased stability => The aircraft is less resistant to AOA and velocity changes.

The COG position that gives neutral stability is defined as the neutral point. (NP)

The degree of pitch stability or instability is traditionally specified by the Stability Margin.

SM= (xnp - xcg)/c

Figure: Natural responses

to a pitch disturbance for

different amounts of

pitch stability.

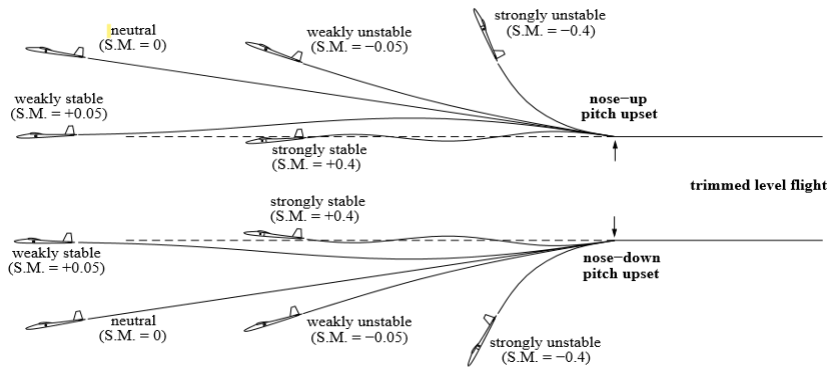
[picture p36: figure]

From Fig, we can determine the optimum stability margin for a pitch disturbance. Stability margin

cannot be negative at the same time the value cannot be largely positive due to undesirable effects. One

large drawback of a large S.M. is that it causes large (and annoying) pitch trim changes with changing

airspeed.

Ideal range of SM obtained from experimental results is

Analytical equation to calculate the neutral point of the plane is mentioned below:

Xnp = 3.027 inches (for 10.1 inches MAC).

We chose the mid value of Stability margin which is 0.10.

Xcg = 2.017 inches (from MAC of 10.1 inches).

3.1.6. Landing gear: The main function of landing gear is to absorb and dissipate the kinetic energy

of landing impact, thereby reducing the impact loads transmitted to the airframe. Landing gear can be

fixed either in fuselage or in main wing. It would be better if we attach the landing gear to the fuselage as it would carry all the load ensuring a safe wing. Though there are roughly 10 configurations of

landing gear, analysing the pros and cons narrowed us down to two configuration, tricycle and inverted

tricycle. While landing, rear wheel would have initial contact with ground and hence it shall take

maximum load. Thus, 2 tyres in the rear to ensure safe landing led us to Tricycle configuration.

3.2. Detailed Design: It is in the detailed design phase that serious structural and control system

analysis and design take place. We expected the end of detailed design phase to bring a major change -

to commit to the fabrication of plane or not.

### 3.2.1. 3-D Drag analysis (Analytical) Airfoil Drag polar equation:

From Table.2, value of k for S-1223 airfoil was found out to be 0.0668 and Cdo = 0.01758

Wing drag polar equation

CD,o = Parasite drag of wing mainly due to skin-friction and pressure distribution around the airfoil.

2

nd term = inviscid drag-due-to-lift | 3 rd term = viscous drag-due-to-lift
CD = Drag polar | Cl,o = Cl for minimum wing drag
Item | Planform area | Wetted area | Reference length
Fuselage | 300 sq inch | 1200 sq inch(approx) | 50 inches
Wing | 720 sq inch | 1440 sq inch | 10.1 inches
Horizontal stabilizer | 133.94 sq inch | 267 sq inch | 5.3 inches
Vertical stabilizer | 83 sq inch | 160 sq inch | 6

CD,O value for wing is practically equal to Cd,o ( parasite drag fir airfoil ) = 0.01758

Aircraft Drag polar equation

Value of CD,O in the aircraft drag polar equation is different from the CD,O present in wing drag polar

equation . CDo results from pressure and skin friction drag due to fuselage, wing, tails, landing gear,

engine, etc. Major contributors in the case of an RC plane being the first four, drag due to other

components are neglected.

CD,O for Fuselage

Fuselage CDo = FF*Cf*SWet/SRef

FF = form factor representing a pressure drag contribution

Cf = skin friction coefficient of the component (fuselage)

SWet = wetted area of the component

FFf = 1 + 60/(FR)^3 + 0.0025 FR

For our model the FR = fuselage fineness ratio =

fuselage length/diameter [ 50/7 = 7.14]

FF= 1.182

Cf = 0.0041

CDo = 0.0193

CDo for Wing

Cf= 0.00609

FFw = [1 + (0.6/(x/c)m)*(t/c) + 100(t/c)4]

(x/c)m = maximum t/c location of the airfoil

FFw = 1.388

CDo = 0.0169.

CDo for Horizontal stabilizer

Horizontal stabilizer- airfoil NACA 0009

Cf = 0.0032 , FFhs = 1.1213, CDo = 0.007

CDo for Vertical stabilizer

Cf = 0.0029, FFvt = 1.1213, CDo = 0.00062.

Total CD,O = 0.0193+0.0169+0.007+0.00062 =

0.043

CD = 0.043 + 0.08599 + 2.27*10^-3 = 0.13127

Therefore, from the analytical 3D drag analysis

performed, total drag coefficient for the aircraft

is 0.13127.

L/D ratio

CL ideal for the aircraft is 1.1554*0.9*0.9 = 0.93

Total CD = 0.17 ( 0.4 has been added for the

drag contribution of landing gear and other

components extruding out of the surface.

(L / D)max = (CL / CD)max = 0.93 / 0.17 = 5.47.

### 3.2.2. Structural Analysis:

We performed Static Structural Analysis in Solid Works and ANSYS Workbench. This is done to

identify the location of spars, internal design of ribs, number of ribs required and distance between ribs.

1) Location of Spars and Internal Design of ribs: Spars resist bending and forms wing box for

stable torsional resistance. Ribs helps in maintaining the aerodynamic profile of the wing and

also ensures the structural integration.

From Literature work, we found 3 widely used internal design whose pictures are given below:

We used the basic bending equation, which is

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
Where, M= Bending moment, I= Moment of

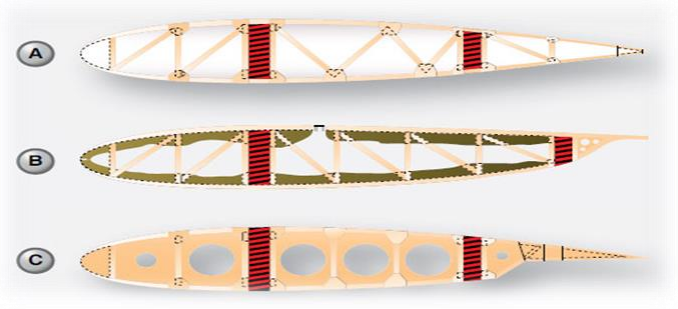
[picture p37: figure]

Inertia (obtained from solid works), σ= Yield stress, Y= Distance from the neutral axis, E= Youngs

modulus and R= Radius of curvature.

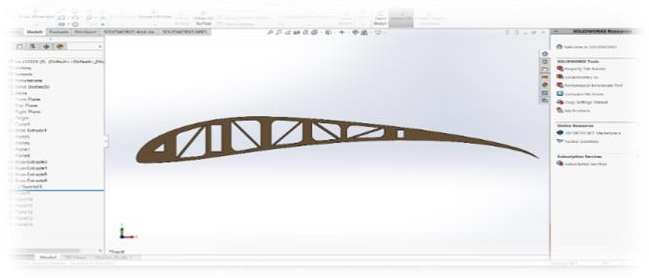
[picture p38: figure]
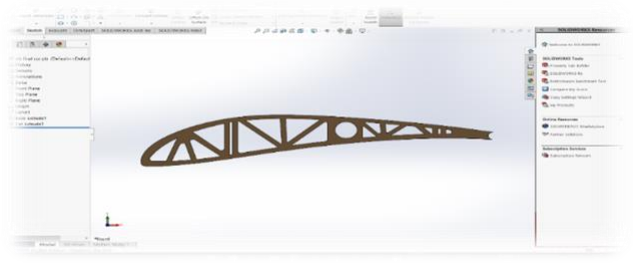
[picture p39: figure]

Fig. a | Fig. b

Factor of safety of 3 was used while substituting for ‘σ’ and we made sure the rib at the root bears the

bending moment generated considering ‘lift’ as a uniformly distributed load. The maximum lift

generated was calculated to be 55.42N, taking maximum co-efficient of Lift as 2.062(including High-lift

devices). Surprisingly, all our designs bore this load. Intense discussions and trade-offs led us to choose design ‘Fig.a’ using Aluminium sheets and rods as spars. Three spars are used- at the location of

maximum camber, 2/3rd the distance from the leading edge and in the middle in such a way that the

Centre of gravity coincides with aerodynamic centre. The front and rear spars are ‘I’ section since their

webs and flanges withstands axial and shear stress and a hollow-rod in the middle. Holes are made

evenly in the spars to reduce weight.

The choice of distance between the ribs was an iterative process where we ran simulations by applying

pressure load to the skin between two ribs and checked if it fails. Skin transmits the aerodynamic forces

to the longitudinal and transverse supporting members.

We determined the magnitude of maximum Co-efficient of pressure (Cp) acting on the airfoil.

Cp = (Po − Pa)/ 5 ∗ ρ ∗ Vc

2
, from which ‘Po – Pa’ was calculated to be 350 Pascals.

Po – Stagnation pressure.

Pa- Free stream Pressure.

ρ= Density (1.225 Kg/m³
).

Vc= Cruise speed= 10 m/s.

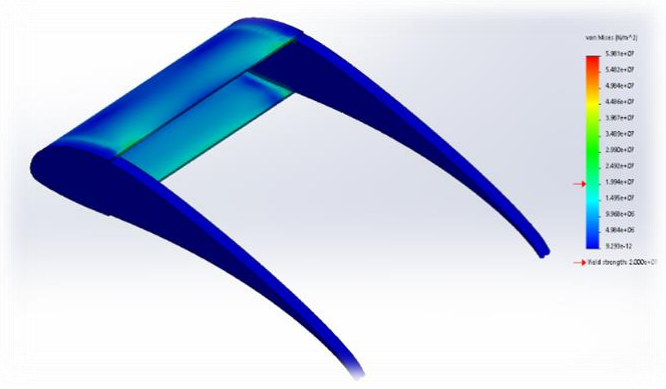
[picture p40: figure]

Usually the distance between ribs were from 1-5

inches (Literature study). The above simulation

performed in solid works for distance between the

ribs as 3.5 inches and thickness of skin as 2mm

shows that the skin buckles at a particular location,

whose stress value indicated by the red arrow mark.

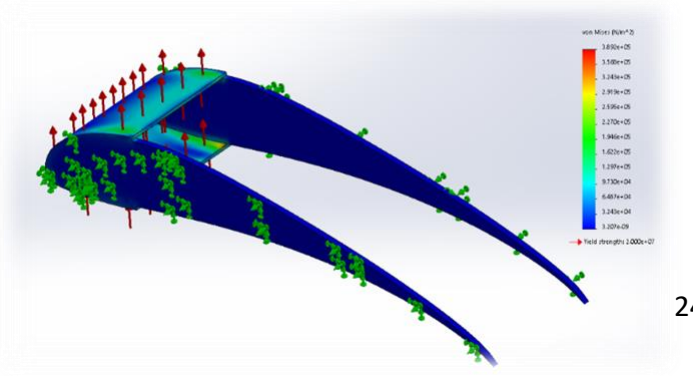
[picture p41: figure]

Multiple trials helped us conclude the distance

between ribs as 2.8 inches and thickness of the skin used as 3mm. The material property given for ribs is that of Grain C Balsa wood and the skin is

Grain A balsa wood. Here, tests were performed on skin extending only till maximum camber, after

which monokote will be used as the skin. Therefore, we made sure that the entire load is borne by the

skin made of balsa only.

### 3. Power Plant:

The old saying that “you cannot get something out of nothing” is particularly true in engineering.The

previous sections have discussed the aerodynamic lift and drag; the performance, stability and control of

airplanes. All this takes the expenditure of Power, or energy which is supplied by an engine or

propulsive mechanism of some type, propellers in this case. This section walks through the procedure of

selection of propeller size, pitch and also about the battery selection.

Airplane wings and propeller have something in common. They are both made up of airfoil sections

designed to generate an aerodynamic force. The wing force provides lift to sustain the airplane in air; the

propeller force provides thrust to push the airplane forward through air. The difference is that the

propeller rotates at a high RPM whereas a wing flies almost at same speed. This characteristic of

propeller blade is the reason for the varying velocity from root tip; maximum at the tip and minimum in

the root. The probability of propeller failing in the middle is maximum compared to other places owing

to maximum stress. The stress results from the combination of centrifugal and thrust forces adding to the

blade’s airfoil twisting moment trying to twist them. Diameter and Pitch are the two important

parameters of a propeller that decides the amount of thrust the engine produces. Diameter is the distance

between tip to tip and pitch is the distance the propeller moves in one revolution if it were to move

through a soft solid. Increasing both diameter and pitch would increase the load on the engine resulting

in reduction of RPM. Generally, for a high-speed flight small diameter and increased pitch is used and

vice versa. In the previous section, we saw that Wing Loading can vary from 16-22 oz/ft²
from which 20

oz/ft²
is chosen.

From graph, the required speed is found to be 40mph.

This is the minimum speed that must be maintained but

25% of the speed is added resulting in 50mph owing to

take-off requirements. The thrust to weight ratio (T/W)

was finalised as 0.8 (previous section).

Thrust/Weight=0.8.

Thrust= 0.8 * 5700g =4600g.

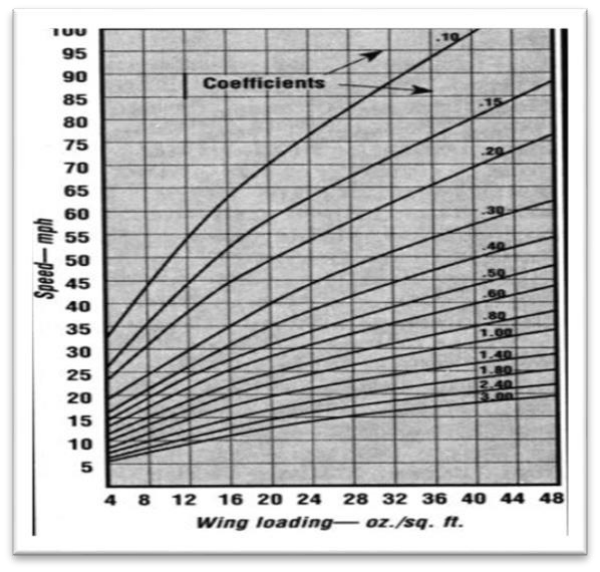
[picture p42: figure]
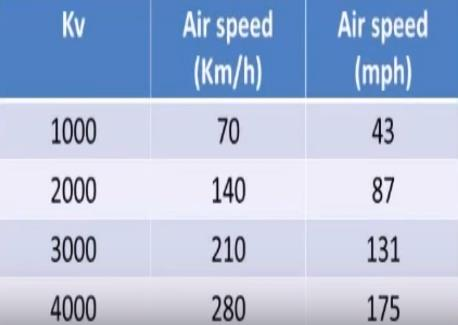
[picture p43: figure]

The air speed 43mph (20 m/s) is considered (little high), which will

get reduced once the loads on the aircraft are considered.

A 1000 Kv motor is finalised since requirements demand only a low

air speed aircraft, and as stated above, a larger propeller diameter will

be used owing to the selection of relatively low Kv motor.

W/g= (0.17) *(KV/1000) +0.09, the thrust to power ratio is

calculated to be 0.26.

Power=0.26*4600g= 1196W.

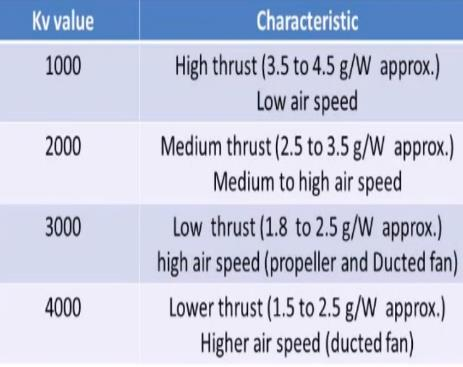
[picture p44: figure]

It is always recommended to choose higher values of power (generally 40% to 50% higher) to ensure

easy fly at 50 to 60% throttle. Kv= unloaded RPM/volt.

Unloaded RPM- the speed at which the propellers rotate at no load condition.

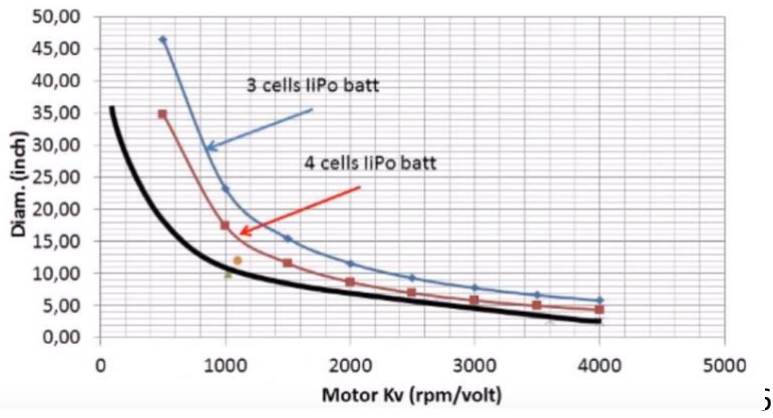
[picture p45: figure]

| 1000=unloaded RPM/14.
| Unloaded RPM=14000.
| Conclusion: 12-inch propeller for 935 Kv
| motor and a 6-cell battery.

4.1. Static and Dynamic Thrust Calculator: The static and dynamic thrust was calculated using an

online calculator. http://electricrcaircraftguy.blogspot.com/2013/09/propeller-static-dynamic-thrust-

equation.html (http://electricrcaircraftguy.blogspot.com/2013/09/propeller-static-dynamic-thrust-equation.html)

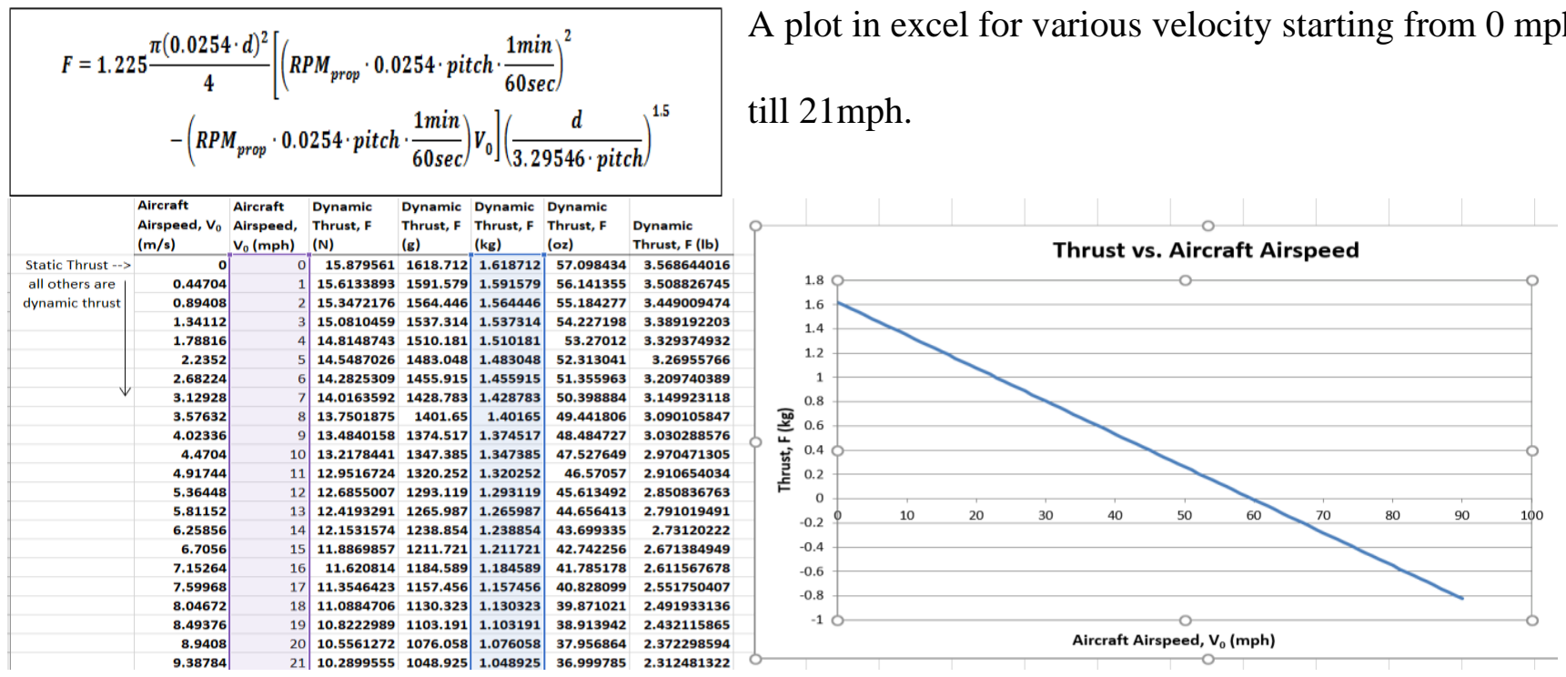
[picture p46: figure]
till 21mph.

A plot in excel for various velocity starting from 0 mph

4. Servo-Sizing.

The Control surfaces of the aircraft are actuated using servos. In order to determine the apt servo

size, it is necessary to calculate the torque required to move the control surface. Accordingly, the

servo size is determined.

The Formula used is- Torque (oz.-in) = 8.5E-6 * (C 2* V 2* L* sin(S1) * tan(S1) /tan(S2)).

C = Control surface chord (cm). | L = Control surface length (cm).
V = Speed (MPH). | S1 = Max control surface deflection in degrees.

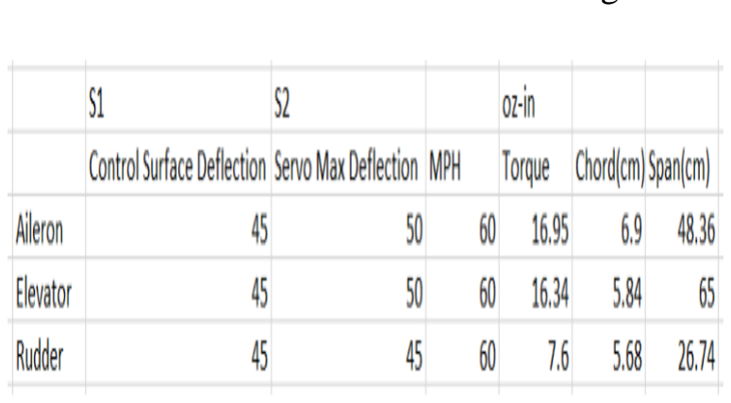
[picture p47: figure]

S2 = Max servo deflection in degrees. | The RC plane is generally operated at a velocity of

40MPH. 60MPH is taken for safer side. The Torque

requirements of the control surfaces can be achieved by

EMAX ES08A Mini Plastic gear servo 8.5g, that

produce 1.5 Kgf-cm torque @4.8V.

### 5. Conclusion:

We are extremely grateful for having been given the opportunity to perform this project, through

which we have undoubtedly gained a plethora of knowledge. The entire designing phase was

challenging and interesting. Every subsystem was preceded by multiple discussions, and sometimes,

we discarded and started afresh on our work as well. Although many our results proved to be

positive theoretically, following our intuition and gut feeling delayed the process of finalising sub-

systems. Hence, we created and tested a scaled down prototype of the design without landing gear

(to evaluate wing, horizontal and vertical stabilizer performances). Flight performances were

observed, noted and altered.

The prototype model:

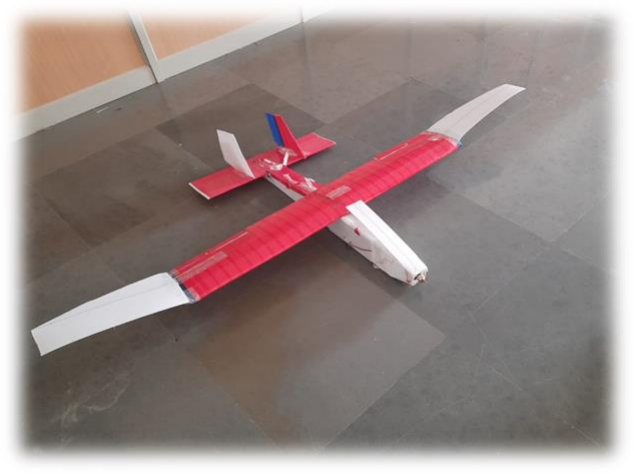
[picture p48: figure]

Our Final Wing Design and lift distribution in XFLR file.

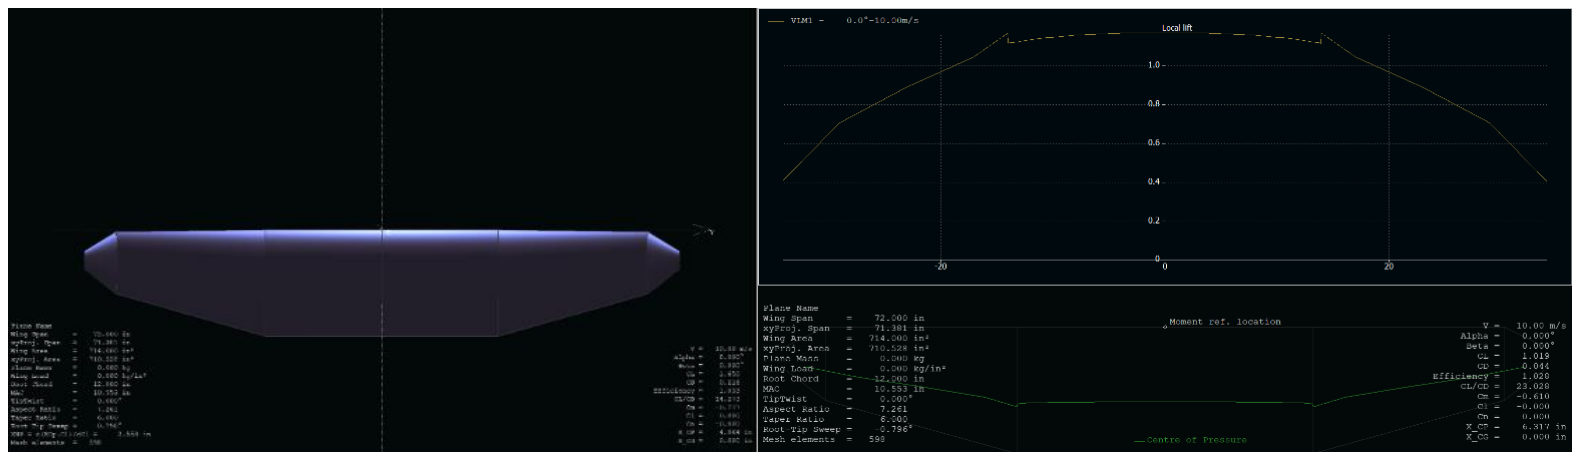
[picture p49: figure]

## 6. Payload Prediction Graph

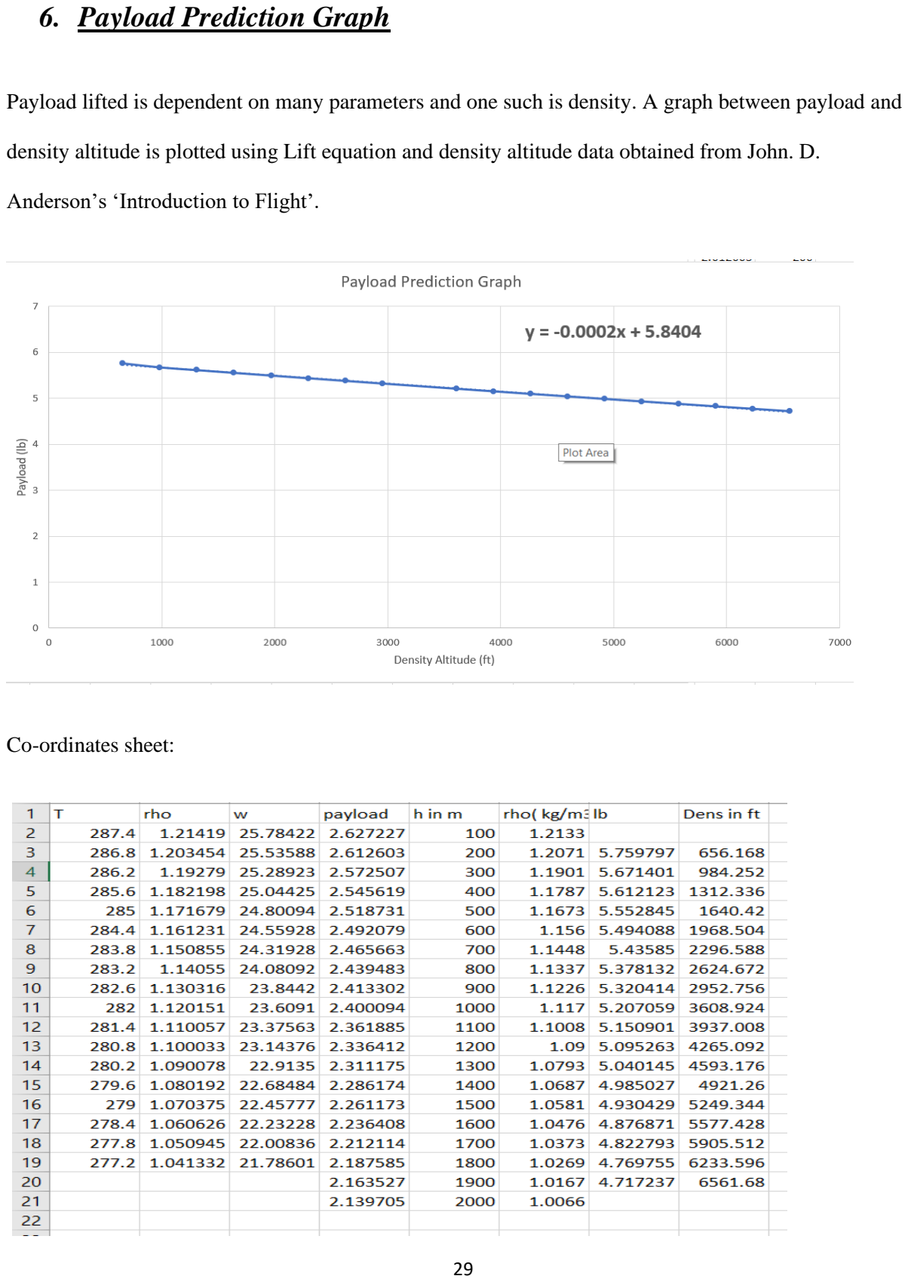
[picture p50: page 29]

Payload lifted is dependent on many parameters and one such is density. A graph between payload and

density altitude is plotted using Lift equation and density altitude data obtained from John. D.

Anderson’s ‘Introduction to Flight’.

Co-ordinates sheet:

KINDLY CONSIDER THIS AS 31ST PAGE AND 2D DRAWING AS 30TH PAGE.

1. Lennon, A., "Basics of R/C Model Aircraft design: Practical Techniques for Building Better Models", Air

Age media, September 1996, ISBN-13: 978-0911295405

2. Simmons, M., "Model Aircraft Aerodynamics, Fourth Edition," (Chris Lloyd Sales & Marketing, March 3,

2000), ISBN-13: 978-1854861900

3. Anderson Jr, J.D., "Fundamentals of Aerodynamics, 5th edition, (McGraw-Hill Education, February 12,

2010), ISBN-13: 978-0073398105

4. MIT Open Course Ware, "Basic Aircraft Design Rules," http://ocw.mit.edu/courses/aeronautics-and-

astronautics/16-01-unified-engineering-i- ii-iii-iv-fall-2005-spring-2006/systems-labs-06/spl8.pdf, accessed

Jan. 2016.

5. University of Maine, SAE Aero Capstone Group, "Design, Construction and Testing of a Remote

Operation Heavy - Lift Model Aircraft," https://mhmaberry.files.wordpress.com/2015/03/umaine-sae-aero-

design-final- report.pdf, accessed Dec. 2015.

6. Department of Mechanical Engineering, Northern Arizona University, final report document, "SAE Aero

West Design Report 2013,"

7. Gadd, C., Servo Torque Calculator, Online Software, Scale Flyers of Minnesota,

http://www.mnbigbirds.com/Servo%20Torque%20Caculator.htm, accessed Jan. 2016.

8. Füzesi, S., Static Thrust Calculator (Version 9.3), Online Software,

http://personal.osi.hu/fuzesisz/strc_eng/, accessed Jan. 2016.

9. NACA report no. 738, “GROUND EFFECT ON DOWNWASH ANGLES AND WAKE LOCATION “, BY
S. KATZOFF AND HAROLD H. SWEBERG.

10 Stability and Control, http://adg.stanford.edu/aa241/stability/sandc.html

11. “Airplane Aerodynamics and Performance”, Dr. Jan Roskam and Dr, Chuan- Tau Edward Lan ISBN 1-

884885-44-6

12. “Strength of Wings A WorkinProgress” Friday, 13Jun2003 08:12:17 EDT
13. Sadraey M., Aircraft Performance Analysis, VDM Verlag Dr. Müller, 2009
