karthikeya-ms/SAE-Aerodesign-Challenge-2020/SAE Aerodesign/FINAL DESIGN PARTS AND ASSEMBLY/final_assembly.SLDASM

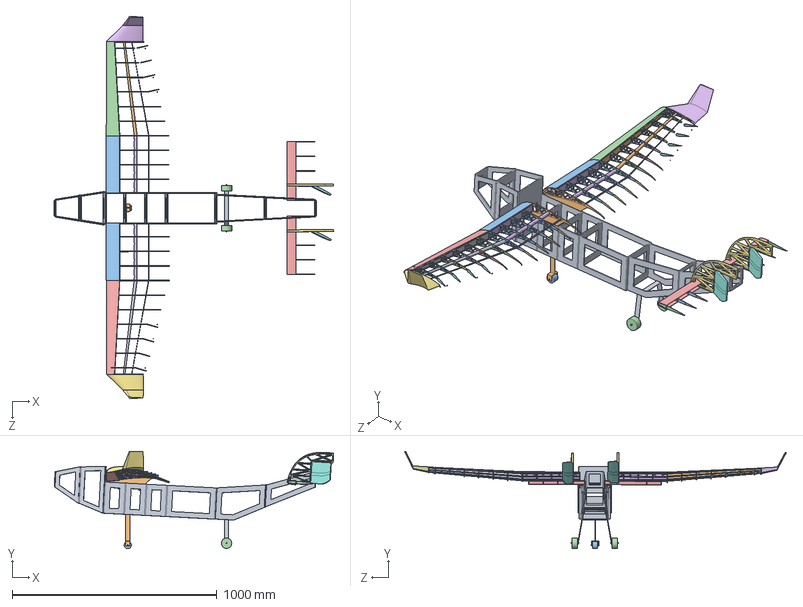
[picture p51: CAD file, 2022-12-06]
SAE Aerodesign/FINAL DESIGN PARTS AND ASSEMBLY/final_assembly.SLDASM
1365.6 x 476.2 x 1866.4 mm
fuselage
fuselage connector x 2
rib final cut pb x 8
8.88rib final cut pb x 2
A_grade_balsa_cover x 2
A_grade_balsa_cover2
A_grade_balsa_cover_left
spars middle x 2
flaps x 2
ailerons x 2
spars_left
spars_right2
HSrib_cut x 8
Hortwin x 2
elevator_cover x 2
elevator x 8
new 1.CATPart x 2
new 2.CATPart x 2
land_main
land_nose
tire1.7
tire2.5 x 2
land_rod x 3
winglet_right
winglet_left
