karthikeya-ms/SAE-Aerodesign-Challenge-2020/SAE Aerodesign/FINAL DESIGN PARTS AND ASSEMBLY/horizontal_stabilizer.SLDASM

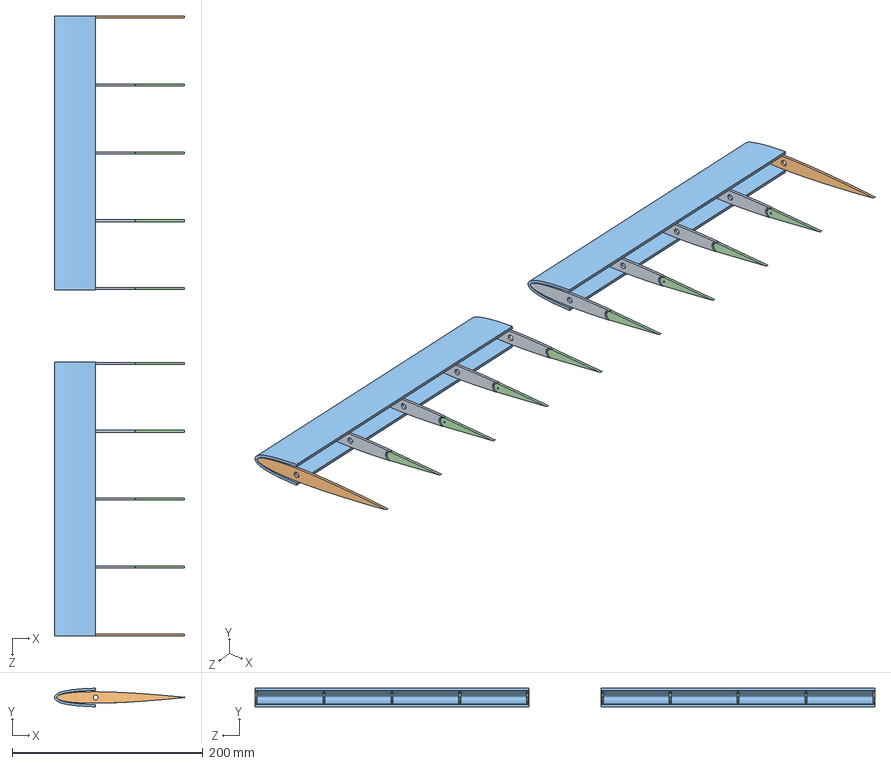
[picture p52: CAD file, 2022-12-06]
SAE Aerodesign/FINAL DESIGN PARTS AND ASSEMBLY/horizontal_stabilizer.SLDASM
136.4 x 19.6 x 650.0 mm
HSrib_cut x 8
Hortwin x 2
elevator_cover x 2
elevator x 8
