karthikeya-ms/SAE-Aerodesign-Challenge-2020/SAE Aerodesign/FINAL DESIGN PARTS AND ASSEMBLY/Vertical_stabilizer.SLDASM

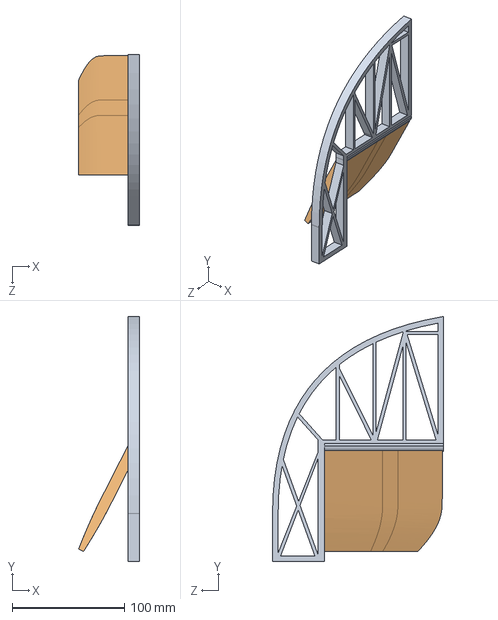
[picture p53: CAD file, 2022-12-06]
SAE Aerodesign/FINAL DESIGN PARTS AND ASSEMBLY/Vertical_stabilizer.SLDASM
54.2 x 218.4 x 152.4 mm
new 1.CATPart
new 2.CATPart
