karthikeya-ms/SAE-Aerodesign-Challenge-2020/SAE Aerodesign/FINAL DESIGN PARTS AND ASSEMBLY/land_main.SLDPRT

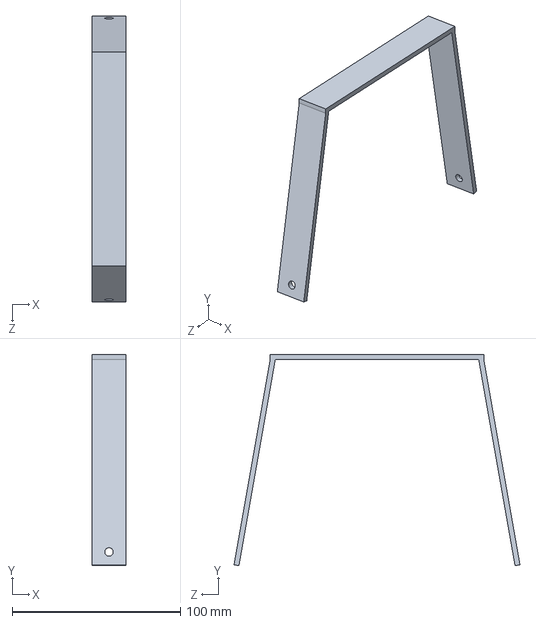
[picture p54: CAD file, 2022-12-06]
SAE Aerodesign/FINAL DESIGN PARTS AND ASSEMBLY/land_main.SLDPRT
20.3 x 125.7 x 170.1 mm
