karthikeya-ms/SAE-Aerodesign-Challenge-2020/SAE Aerodesign/FINAL DESIGN PARTS AND ASSEMBLY/wing assembly.SLDASM

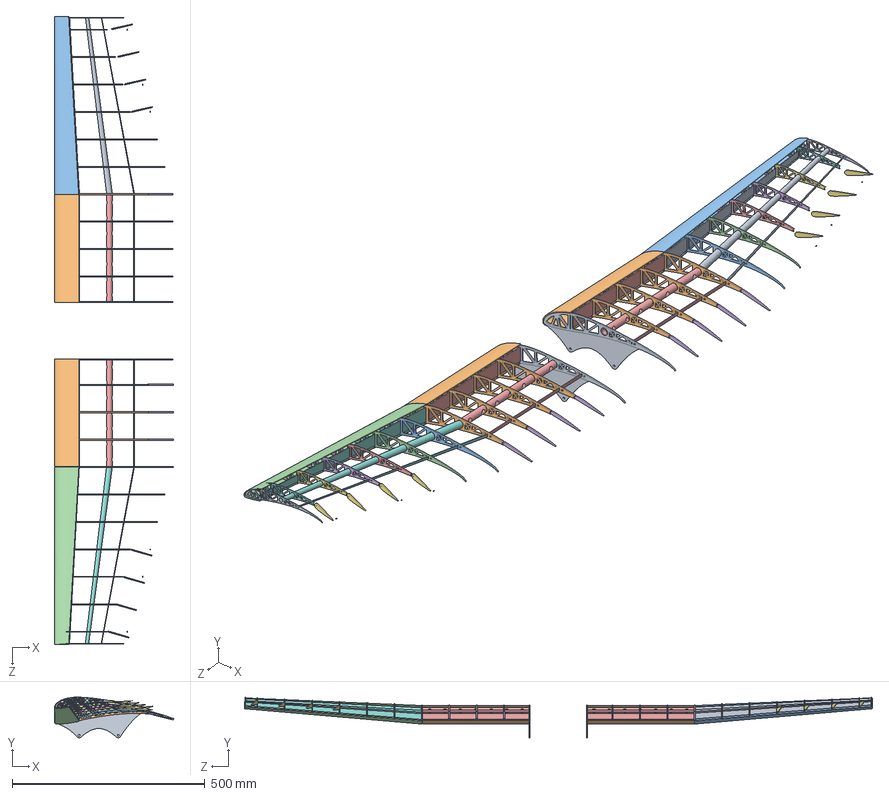
[picture p55: CAD file, 2022-12-06]
SAE Aerodesign/FINAL DESIGN PARTS AND ASSEMBLY/wing assembly.SLDASM
308.8 x 105.7 x 1628.5 mm
fuselage connector x 2
rib final cut pb x 8
8.88rib final cut pb x 2
A_grade_balsa_cover x 2
A_grade_balsa_cover2
A_grade_balsa_cover_left
spars middle x 2
flaps x 2
ailerons x 2
spars_left
spars_right2
