karthikeya-ms/SAE-Aerodesign-Challenge-2020/SAE Aerodesign/FINAL DESIGN PARTS AND ASSEMBLY/landing assembly.SLDASM

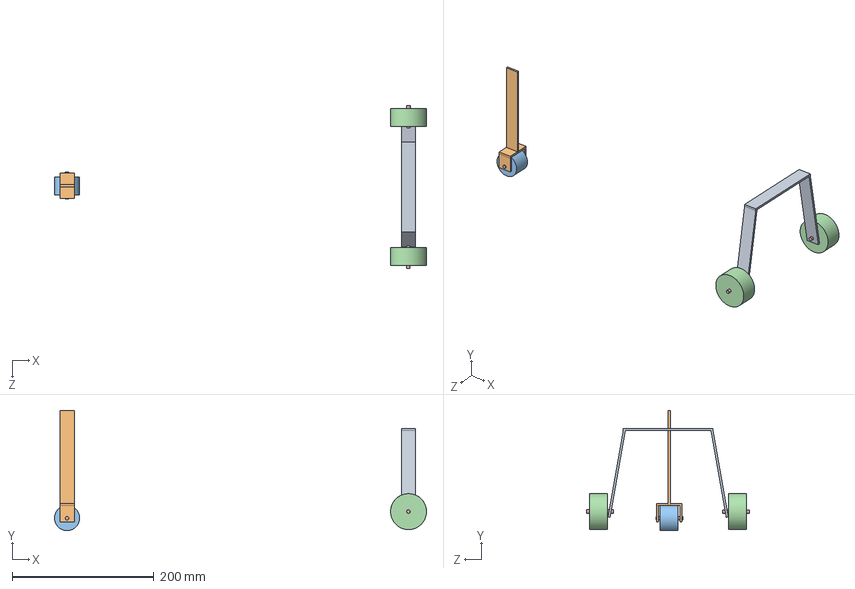
[picture p56: CAD file, 2022-12-06]
SAE Aerodesign/FINAL DESIGN PARTS AND ASSEMBLY/landing assembly.SLDASM
525.8 x 169.9 x 230.4 mm
land_main
land_nose
tire1.7
tire2.5 x 2
land_rod x 3
