karthikeya-ms/SAE-Aerodesign-Challenge-2020/SAE Aerodesign/FINAL DESIGN PARTS AND ASSEMBLY/plain rib.SLDPRT

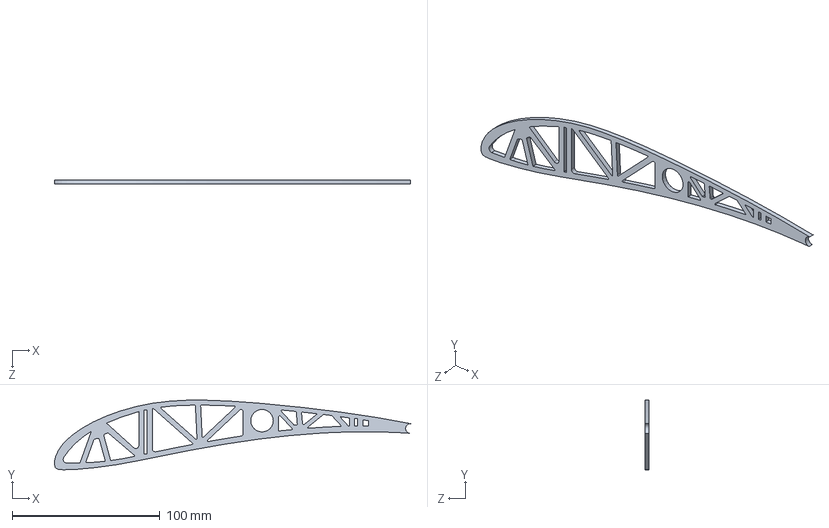
[picture p57: CAD file, 2022-12-06]
SAE Aerodesign/FINAL DESIGN PARTS AND ASSEMBLY/plain rib.SLDPRT
241.3 x 47.2 x 3.00 mm
