karthikeya-ms/SAE-Aerodesign-Challenge-2020/SAE Aerodesign/FINAL DESIGN PARTS AND ASSEMBLY/front fuselage bulk head.SLDPRT

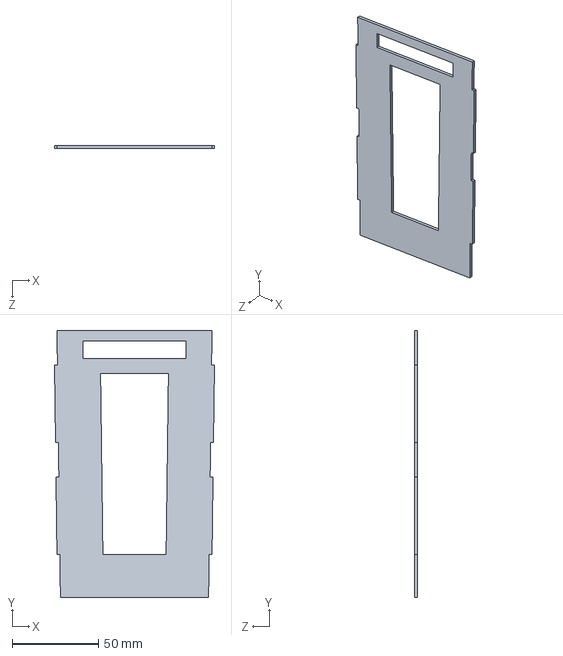
[picture p58: CAD file, 2022-12-06]
SAE Aerodesign/FINAL DESIGN PARTS AND ASSEMBLY/front fuselage bulk head.SLDPRT
92.8 x 154.9 x 2.00 mm
