karthikeya-ms/SAE-Aerodesign-Challenge-2020/SAE Aerodesign/FINAL DESIGN PARTS AND ASSEMBLY/land_nose.SLDPRT

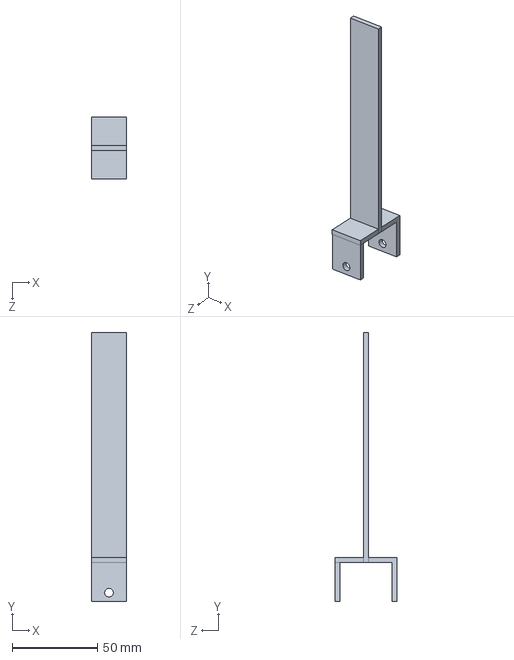
[picture p59: CAD file, 2022-12-06]
SAE Aerodesign/FINAL DESIGN PARTS AND ASSEMBLY/land_nose.SLDPRT
20.3 x 157.5 x 36.5 mm
