karthikeya-ms/SAE-Aerodesign-Challenge-2020/SAE Aerodesign/FINAL DESIGN PARTS AND ASSEMBLY/winglet_left.SLDPRT

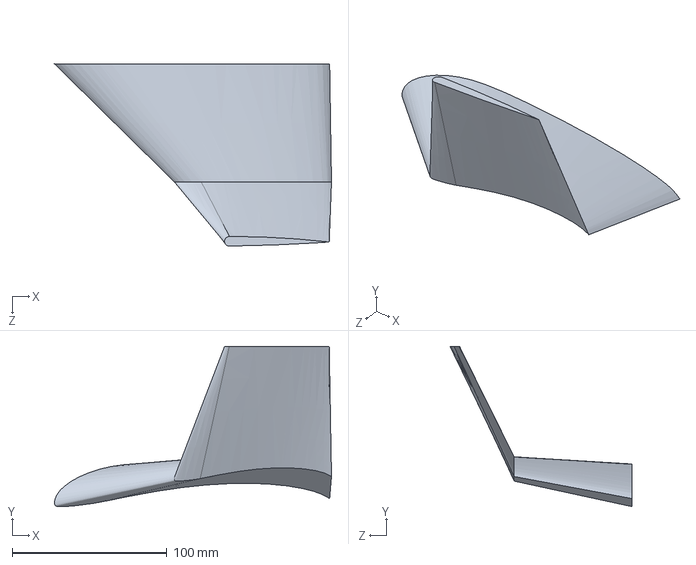
[picture p60: CAD file, 2022-12-06]
SAE Aerodesign/FINAL DESIGN PARTS AND ASSEMBLY/winglet_left.SLDPRT
179.0 x 103.6 x 117.7 mm
