karthikeya-ms/SAE-Aerodesign-Challenge-2020/SAE Aerodesign/FINAL DESIGN PARTS AND ASSEMBLY/land_rod.SLDPRT

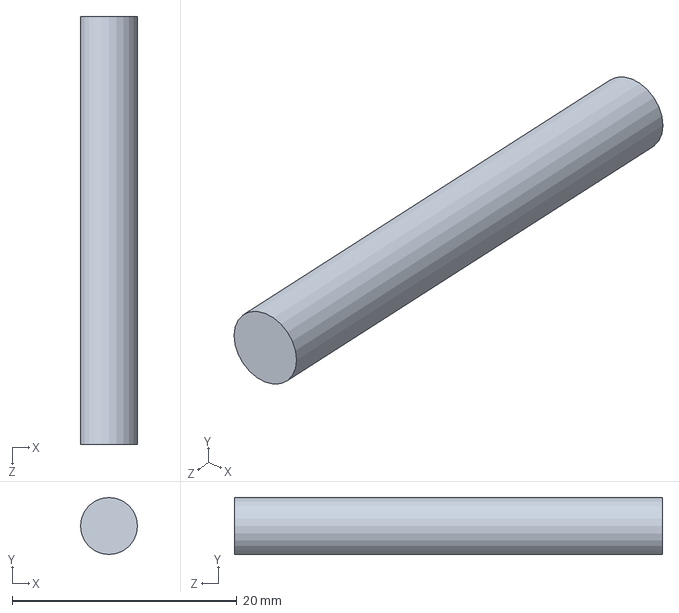
[picture p63: CAD file, 2022-12-06]
SAE Aerodesign/FINAL DESIGN PARTS AND ASSEMBLY/land_rod.SLDPRT
5.08 x 5.08 x 38.1 mm
