karthikeya-ms/SAE-Aerodesign-Challenge-2020/SAE Aerodesign/FINAL DESIGN PARTS AND ASSEMBLY/tire2.5.SLDPRT

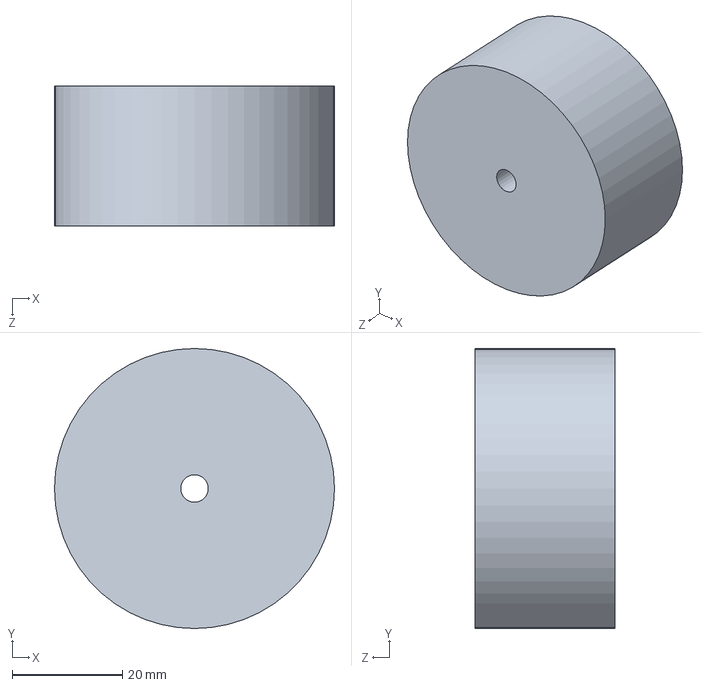
[picture p64: CAD file, 2022-12-06]
SAE Aerodesign/FINAL DESIGN PARTS AND ASSEMBLY/tire2.5.SLDPRT
50.8 x 50.8 x 25.4 mm
