karthikeya-ms/SAE-Aerodesign-Challenge-2020/SAE Aerodesign/FINAL DESIGN PARTS AND ASSEMBLY/A_grade_balsa_cover2.SLDPRT

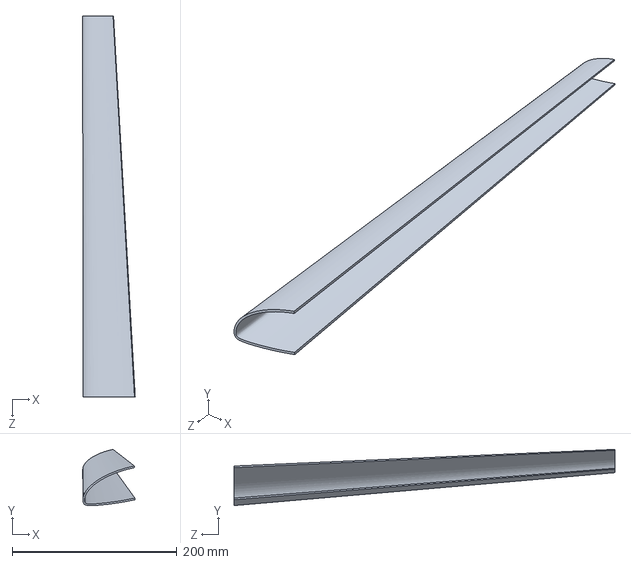
[picture p65: CAD file, 2022-12-06]
SAE Aerodesign/FINAL DESIGN PARTS AND ASSEMBLY/A_grade_balsa_cover2.SLDPRT
63.7 x 68.2 x 462.0 mm
