karthikeya-ms/SAE-Aerodesign-Challenge-2020/SAE Aerodesign/FINAL DESIGN PARTS AND ASSEMBLY/HSrib_cut.SLDPRT

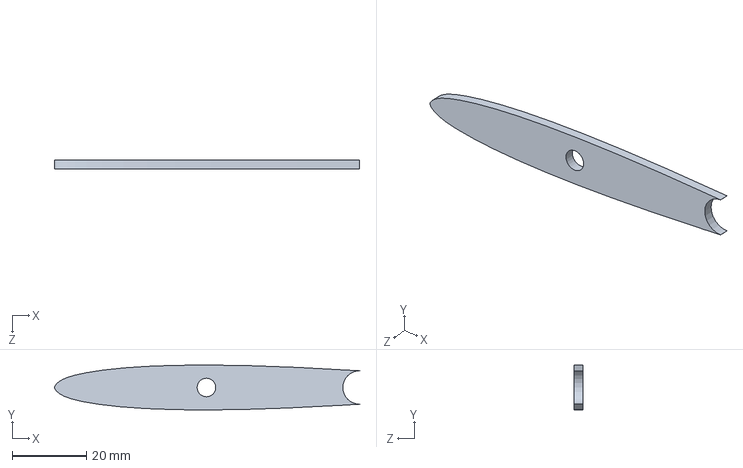
[picture p67: CAD file, 2022-12-06]
SAE Aerodesign/FINAL DESIGN PARTS AND ASSEMBLY/HSrib_cut.SLDPRT
82.0 x 12.1 x 2.29 mm
