karthikeya-ms/SAE-Aerodesign-Challenge-2020/SAE Aerodesign/FINAL DESIGN PARTS AND ASSEMBLY/fuselage.SLDPRT

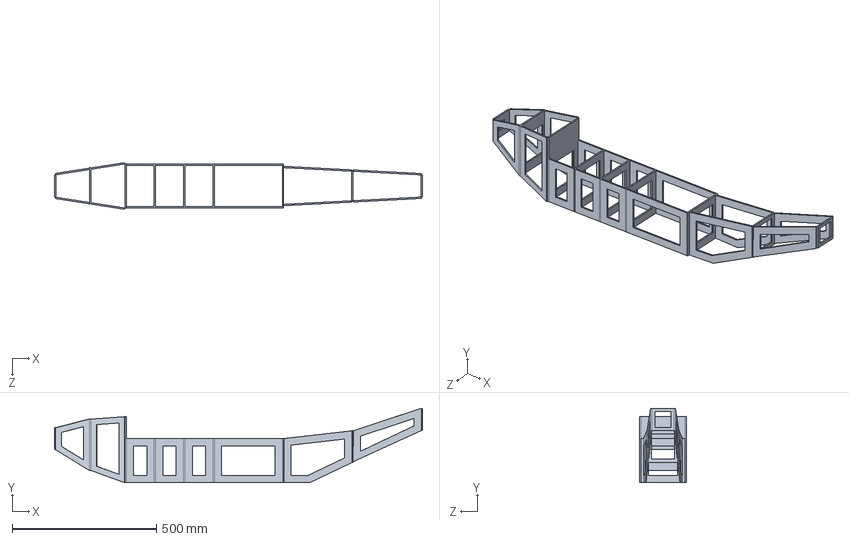
[picture p70: CAD file, 2022-12-06]
SAE Aerodesign/FINAL DESIGN PARTS AND ASSEMBLY/fuselage.SLDPRT
1274.8 x 257.8 x 161.9 mm
