karthikeya-ms/SAE-Aerodesign-Challenge-2020/SAE Aerodesign/FINAL DESIGN PARTS AND ASSEMBLY/tire1.7.SLDPRT

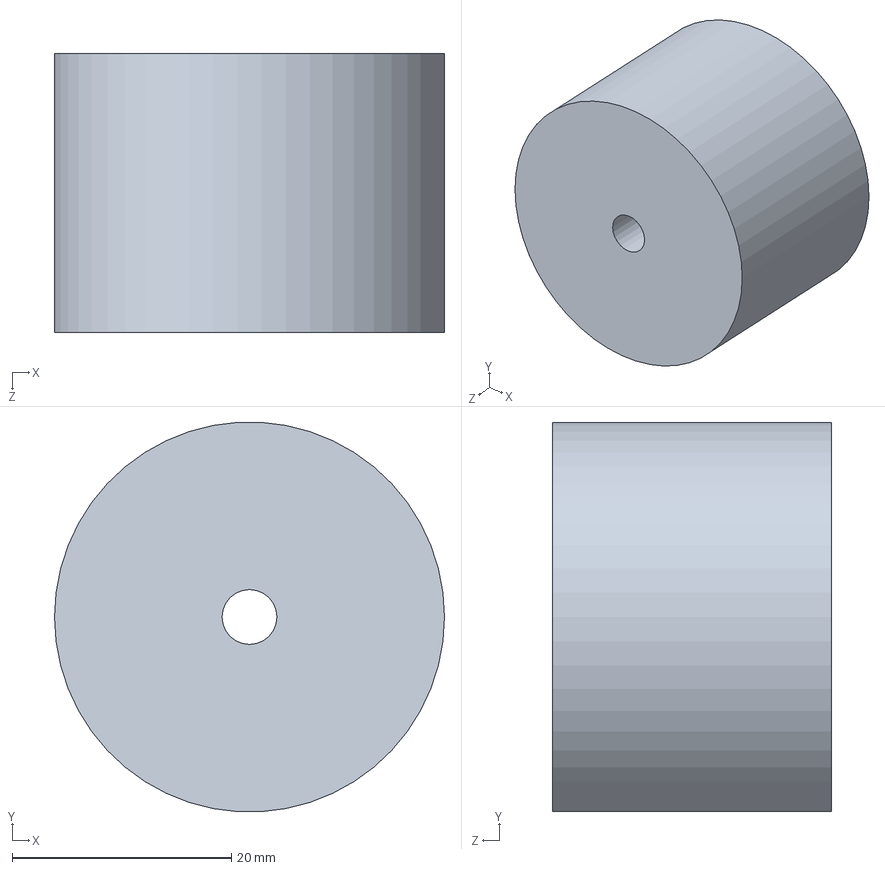
[picture p72: CAD file, 2022-12-06]
SAE Aerodesign/FINAL DESIGN PARTS AND ASSEMBLY/tire1.7.SLDPRT
35.6 x 35.5 x 25.4 mm
