karthikeya-ms/SAE-Aerodesign-Challenge-2020/SAE Aerodesign/FINAL DESIGN PARTS AND ASSEMBLY/Hortwin.SLDPRT

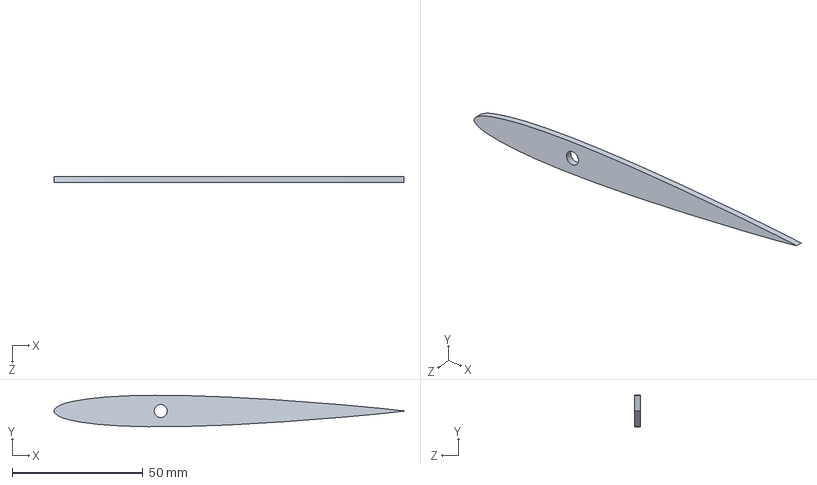
[picture p75: CAD file, 2022-12-06]
SAE Aerodesign/FINAL DESIGN PARTS AND ASSEMBLY/Hortwin.SLDPRT
133.9 x 12.1 x 2.29 mm
