karthikeya-ms/SAE-Aerodesign-Challenge-2020/SAE Aerodesign/FINAL DESIGN PARTS AND ASSEMBLY/ailerons.SLDPRT

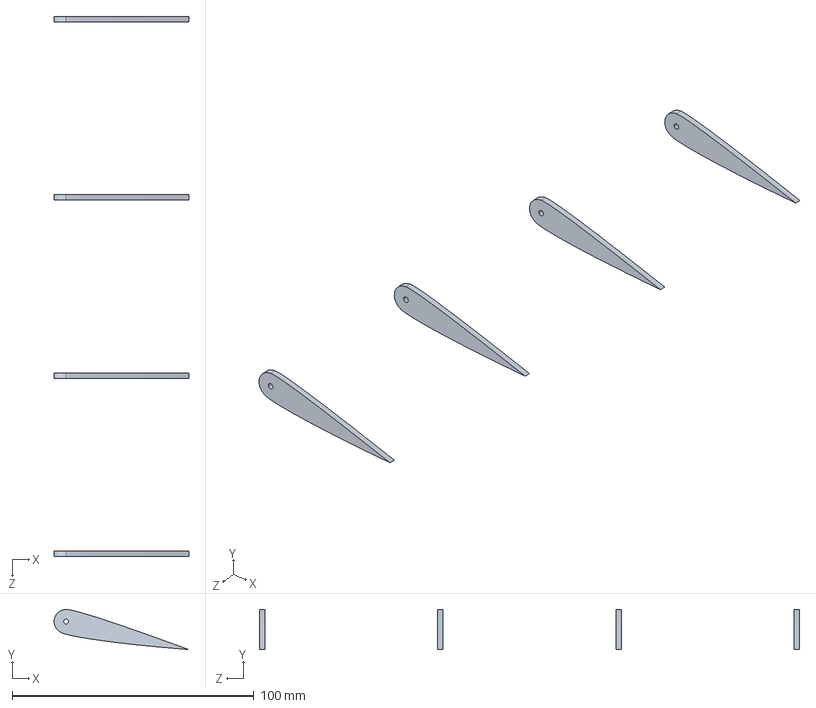
[picture p76: CAD file, 2022-12-06]
SAE Aerodesign/FINAL DESIGN PARTS AND ASSEMBLY/ailerons.SLDPRT
55.8 x 16.6 x 223.3 mm
