karthikeya-ms/SAE-Aerodesign-Challenge-2020/SAE Aerodesign/FINAL DESIGN PARTS AND ASSEMBLY/spars_right2.SLDPRT

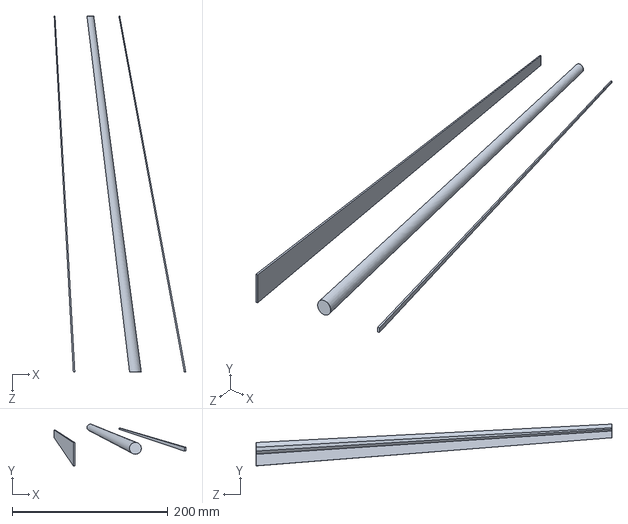
[picture p77: CAD file, 2022-12-06]
SAE Aerodesign/FINAL DESIGN PARTS AND ASSEMBLY/spars_right2.SLDPRT
169.3 x 53.8 x 457.7 mm
