karthikeya-ms/SAE-Aerodesign-Challenge-2020/SAE Aerodesign/FINAL DESIGN PARTS AND ASSEMBLY/spars middle.SLDPRT

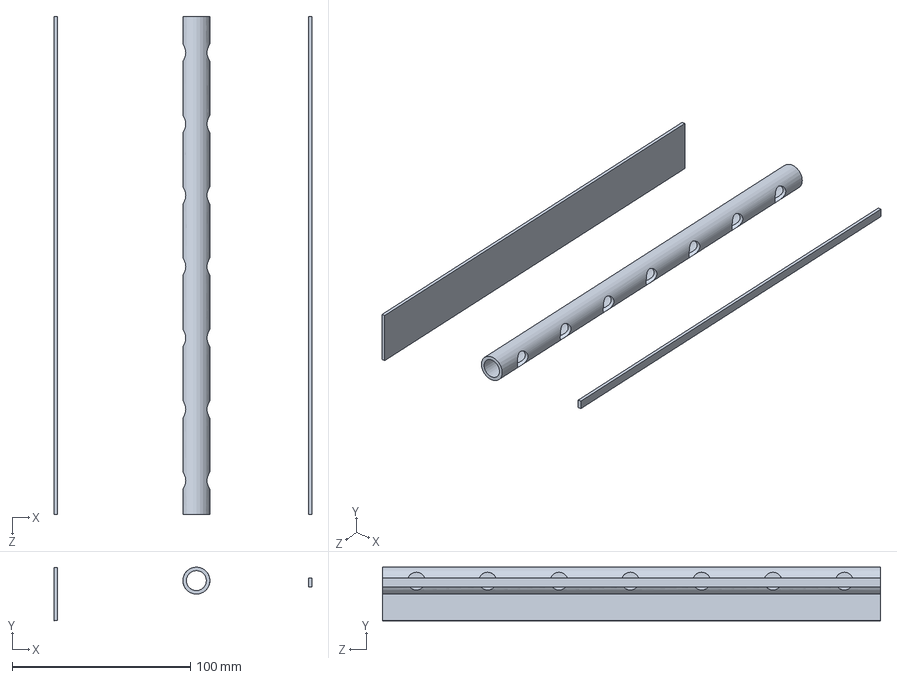
[picture p78: CAD file, 2022-12-06]
SAE Aerodesign/FINAL DESIGN PARTS AND ASSEMBLY/spars middle.SLDPRT
144.7 x 30.2 x 279.4 mm
