karthikeya-ms/SAE-Aerodesign-Challenge-2020/SAE Aerodesign/FINAL DESIGN PARTS AND ASSEMBLY/8.88rib final cut pb.SLDPRT

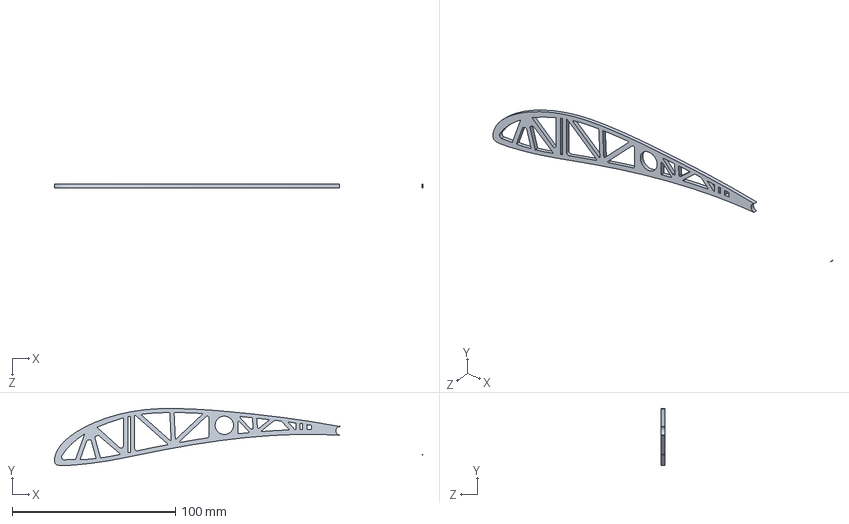
[picture p79: CAD file, 2022-12-06]
SAE Aerodesign/FINAL DESIGN PARTS AND ASSEMBLY/8.88rib final cut pb.SLDPRT
225.8 x 35.0 x 2.22 mm
