karthikeya-ms/SAE-Aerodesign-Challenge-2020/SAE Aerodesign/FINAL DESIGN PARTS AND ASSEMBLY/fuselage connector.SLDPRT

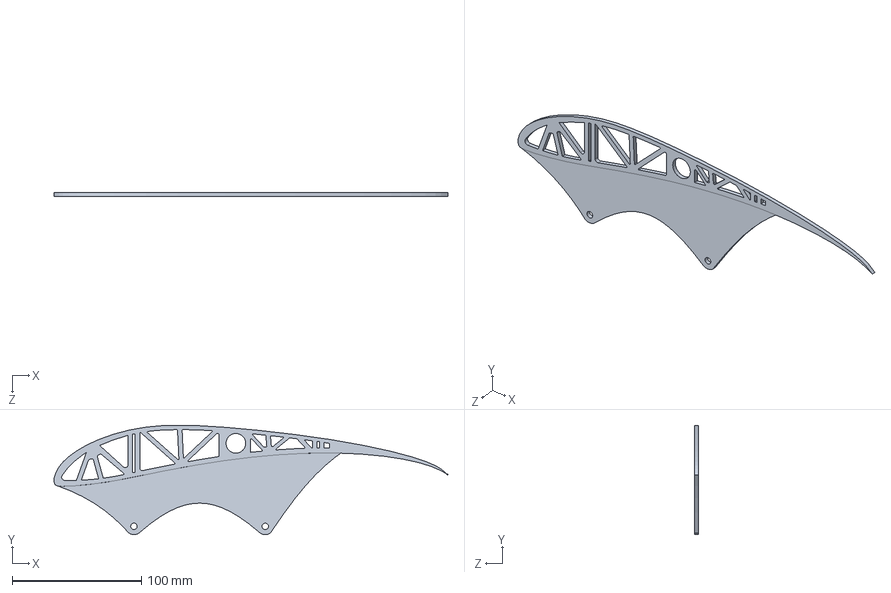
[picture p80: CAD file, 2022-12-06]
SAE Aerodesign/FINAL DESIGN PARTS AND ASSEMBLY/fuselage connector.SLDPRT
304.8 x 84.7 x 3.00 mm
