karthikeya-ms/SAE-Aerodesign-Challenge-2020/SAE Aerodesign/FINAL DESIGN PARTS AND ASSEMBLY/elevator_cover.SLDPRT

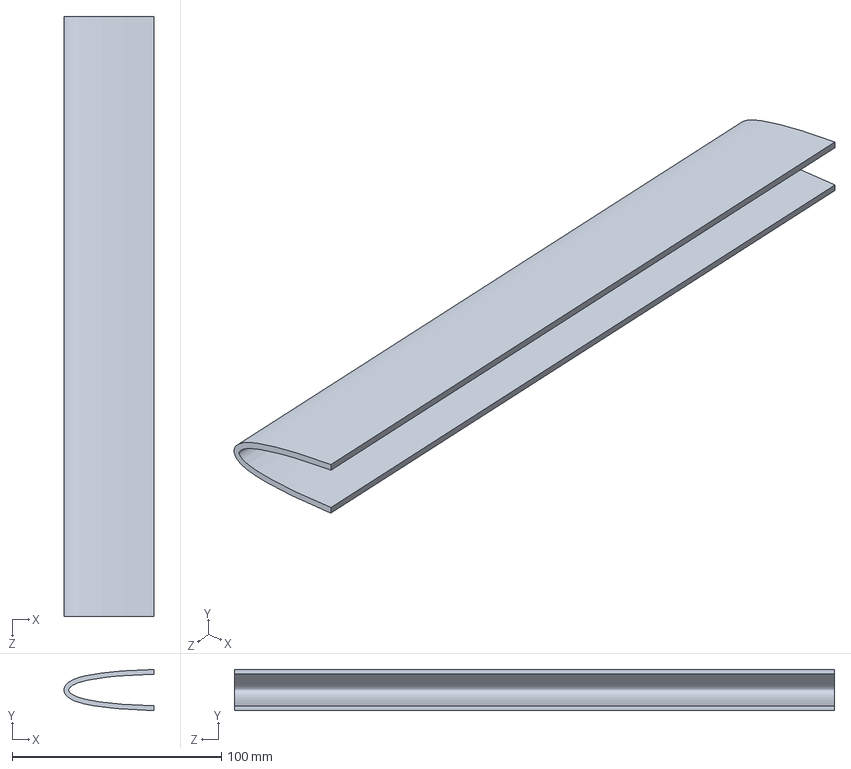
[picture p82: CAD file, 2022-12-06]
SAE Aerodesign/FINAL DESIGN PARTS AND ASSEMBLY/elevator_cover.SLDPRT
43.2 x 19.6 x 287.0 mm
