karthikeya-ms/SAE-Aerodesign-Challenge-2020/SAE Aerodesign/FINAL DESIGN PARTS AND ASSEMBLY/A_grade_balsa_cover.SLDPRT

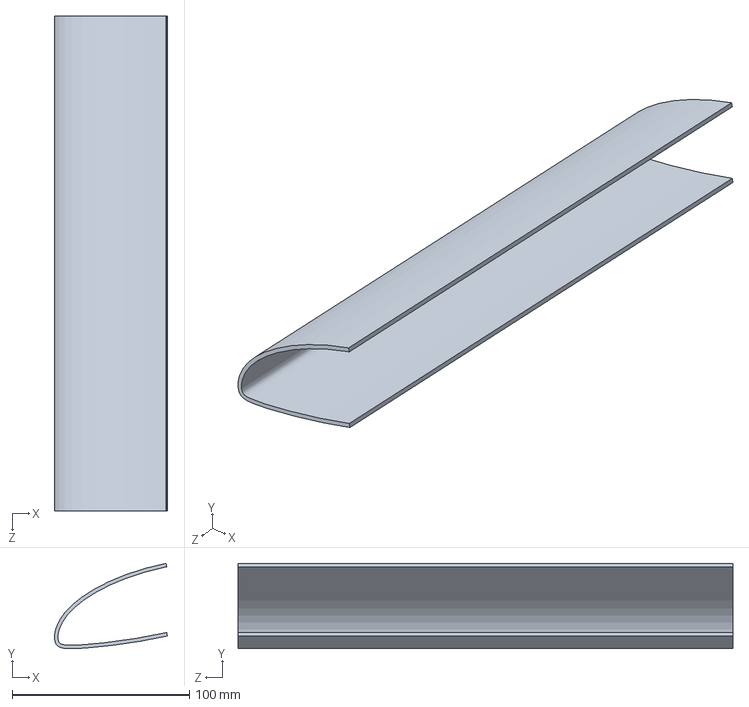
[picture p84: CAD file, 2022-12-06]
SAE Aerodesign/FINAL DESIGN PARTS AND ASSEMBLY/A_grade_balsa_cover.SLDPRT
63.8 x 48.2 x 279.4 mm
