karthikeya-ms/SAE-Aerodesign-Challenge-2020/(list of files, cad)

Other CAD files:
SAE Aerodesign/FINAL DESIGN PARTS AND ASSEMBLY/Part3.sldprt
SAE Aerodesign/FINAL DESIGN PARTS AND ASSEMBLY/winglet_right.SLDPRT
SAE Aerodesign/FINAL DESIGN PARTS AND ASSEMBLY/rib final cut pb.SLDPRT
SAE Aerodesign/FINAL DESIGN PARTS AND ASSEMBLY/A_grade_balsa_cover_left.SLDPRT
SAE Aerodesign/FINAL DESIGN PARTS AND ASSEMBLY/Part2.sldprt
SAE Aerodesign/FINAL DESIGN PARTS AND ASSEMBLY/spars_left.SLDPRT
SAE Aerodesign/FINAL DESIGN PARTS AND ASSEMBLY/final_assembly2D.SLDDRW
SAE Aerodesign/FINAL DESIGN PARTS AND ASSEMBLY/final_assembly2D.pdf.SLDDRW
SAE Aerodesign/FINAL DESIGN PARTS AND ASSEMBLY/front fuselage bulk head.DXF
