karthikeya-ms/SAE-Aerodesign-Challenge-2020/SAE Aerodesign/FINAL DESIGN PARTS AND ASSEMBLY/final_assembly2D.PDF

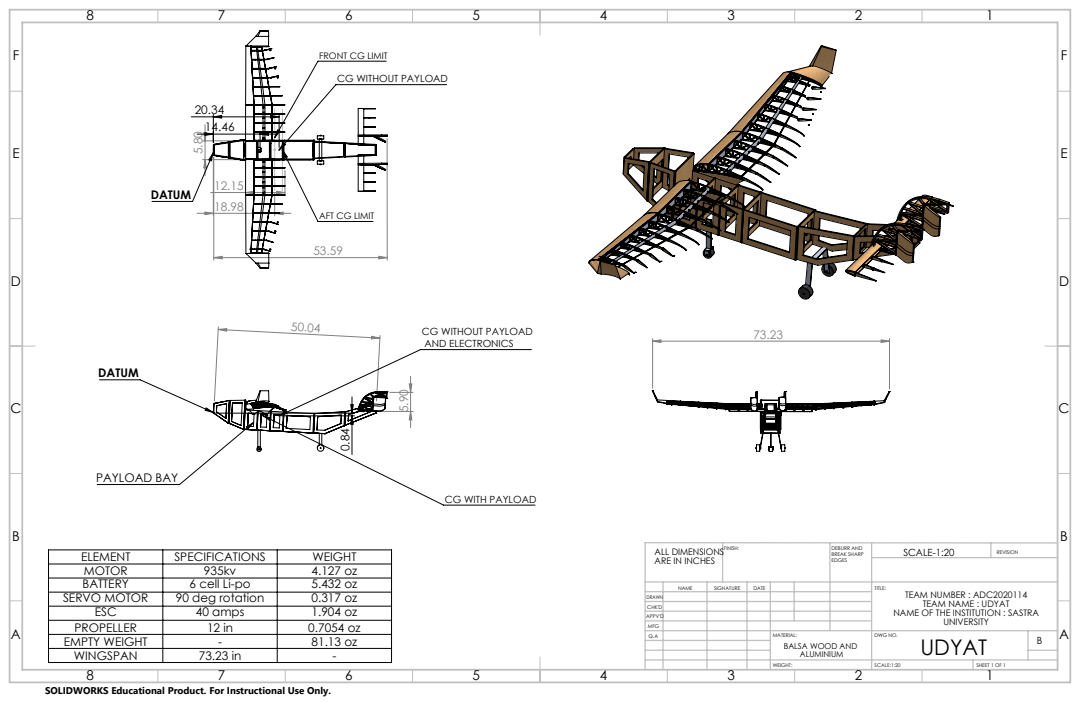
[picture p86: page 1]
PAYLOAD BAY; SERVO MOTOR; 90 deg rotation; PROPELLER; FINISH:; DEBURR AND; BREAK SHARP; DWG NO. B BALSA WOOD AND

FRONT CG LIMIT
CG WITHOUT PAYLOAD

AFT CG LIMIT

AND ELECTRONICS

CG WITH PAYLOAD

ALL DIMENSIONS
ARE IN INCHES

ELEMENT | SPECIFICATIONS | WEIGHT
MOTOR | 935kv | 4.127 oz
BATTERY | 6 cell Li-po | 5.432 oz
ESC | 40 amps | 1.904 oz
EMPTY WEIGHT | - | 81.13 oz
WINGSPAN | 73.23 in | -

NAME | SIGNATURE | DATE | TITLE: TEAM NUMBER : ADC2020114 TEAM NAME : UDYAT NAME OF THE INSTITUTION : SASTRA UNIVERSITY

CHK'D
APPV'D

WEIGHT: | SCALE:1:20 | SHEET 1 OF 1

SOLIDWORKS Educational Product. For Instructional Use Only.
